gustjr3332/Polargrid/sw/edge_ai/polagrid/diagrams/polagrid_architecture.html

Dark

Style

Visual identityS cycles

ClassicStable technical default Signal FlowMotion-forward presentation BlueprintEngineering review EditorialPublication and launch notes

Live Present

Export

Export diagramPortable, clean outputs

E

Share Share Card1200×630 PNG Route Share Card1200×630 PNG Reach Share Card1200×630 PNG Copy Share CardPNG to clipboard Copy diagramPNG to clipboard

Image PNGLossless image JPEGCompact image WebPModern image

Vector & motion SVGEditable vector WebM6s motion

# PolaGrid oneM2M Hierarchy

←

Guided views

Explore this system Step through curated paths without changing the source diagram.

Beat

→

▶ Play story # Copy moment Show all

Ready Chapter 01 / 01

Guided chapter

Diagram guide Explore this system ×

Inspecting compiled semantics

01 Find any nodeSearch labels, responsibilities, kinds, and stable IDs. / 02 Trace a routeAsk how two semantic nodes connect in authored direction. R 03 See the whole systemOpen Semantic Radar with a live viewport and stable nodes. M 04 Compare semantic kindsCount roles, reveal their traffic, and compare direct authored links. L 05 Play the guided storyWalk the authored chapters and real relationships. P 06 Enter Presentation StageGive the live diagram the viewport without changing export. F

E ExportT ThemeS Style0 Reset+ Zoom in- Zoom outEsc Close

Find a node ×

⌕ /

No matching nodes

Semantic passport

Verified source

Authored reach

Upstream0 Downstream0

× Copy link Relations

Route probe Choose a start node Find start Copy link Clear

Pick two semantic nodes on the diagram

← ▶ Journey → Overview

Choose the source, then the destination. Direction matters.

Semantic lens Compare system roles ×

Choose up to two semantic kinds. One reveals its real traffic; two compare only direct authored relationships.

Choose a kind to inspect its nodes and touching relationships.

Copy link Clear

Semantic radar Building overview Open radar ×

Click nodeDrag to pan

Semantic radar needs more MAP space.

PATH MAP LENS 100%

### Measured 2026-10-07

- • 1,000 cells, edge direct: p95 344 ms
- • 1,000 cells via IN: p95 634 ms
- • 0 of 10,000 notifications lost

### Platform

- • tinyIoT c140495 + 4 local patches
- • MN throughput 458 req/s (AE per cell)
- • IN and MNs on SQLite

### Access control

- • IN rewrites CAdmin to /tinyiot/CAdmin
- • Zone ACP grants it on command CNT and GRP

### Real cell (10-19)

- • Firmware builds; PC tests pass
- • Not yet run on hardware
- • MQTT is planned, HTTP polling first
