gustjr3332/Polargrid/hw/archaive/KakaoTalk_20261017_110723910_02.jpg

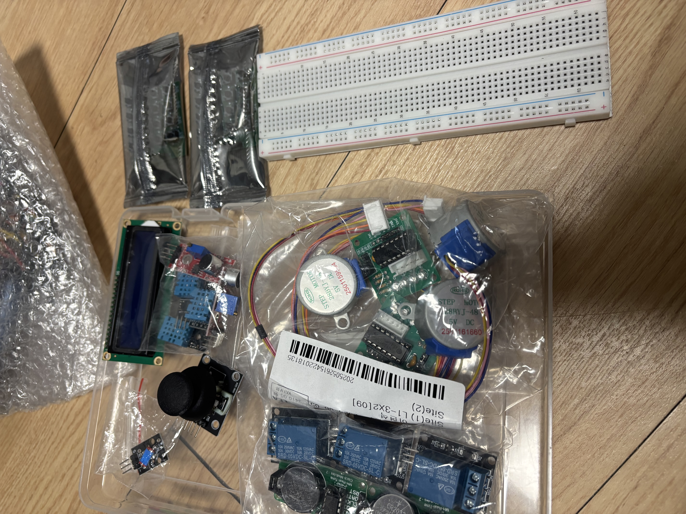
hw/archaive/KakaoTalk_20261017_110723910_02.jpg
