gustjr3332/Polargrid/hw/cutting/cut_overview.png

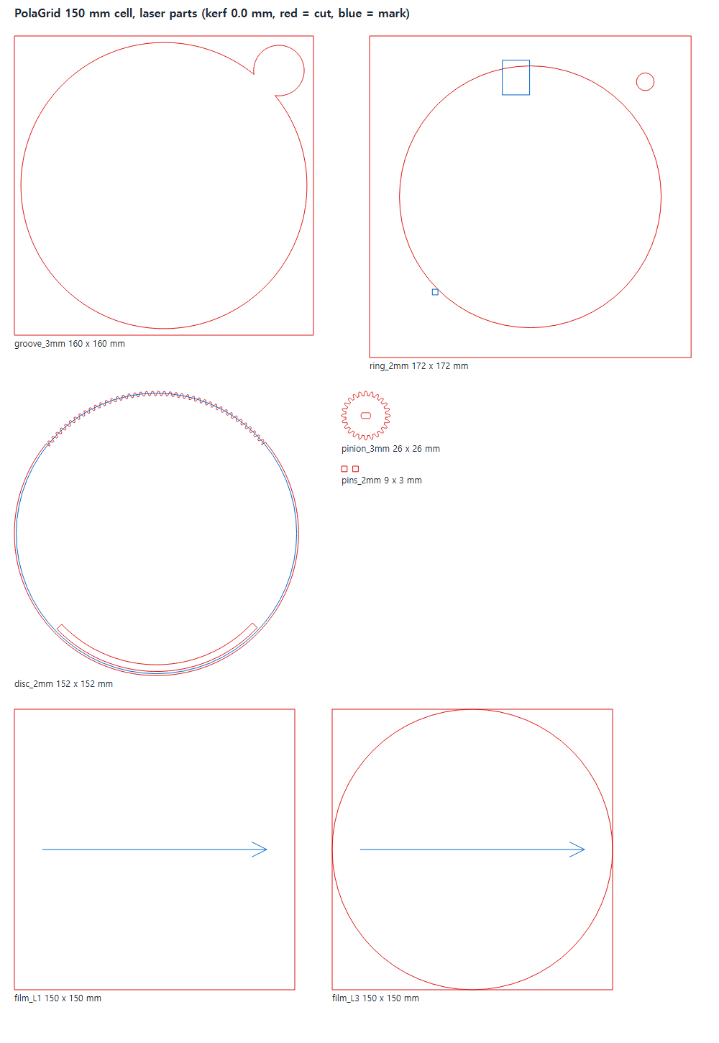
hw/cutting/cut_overview.png
