gustjr3332/Polargrid/hw/diagrams/images/cell150_dark.png

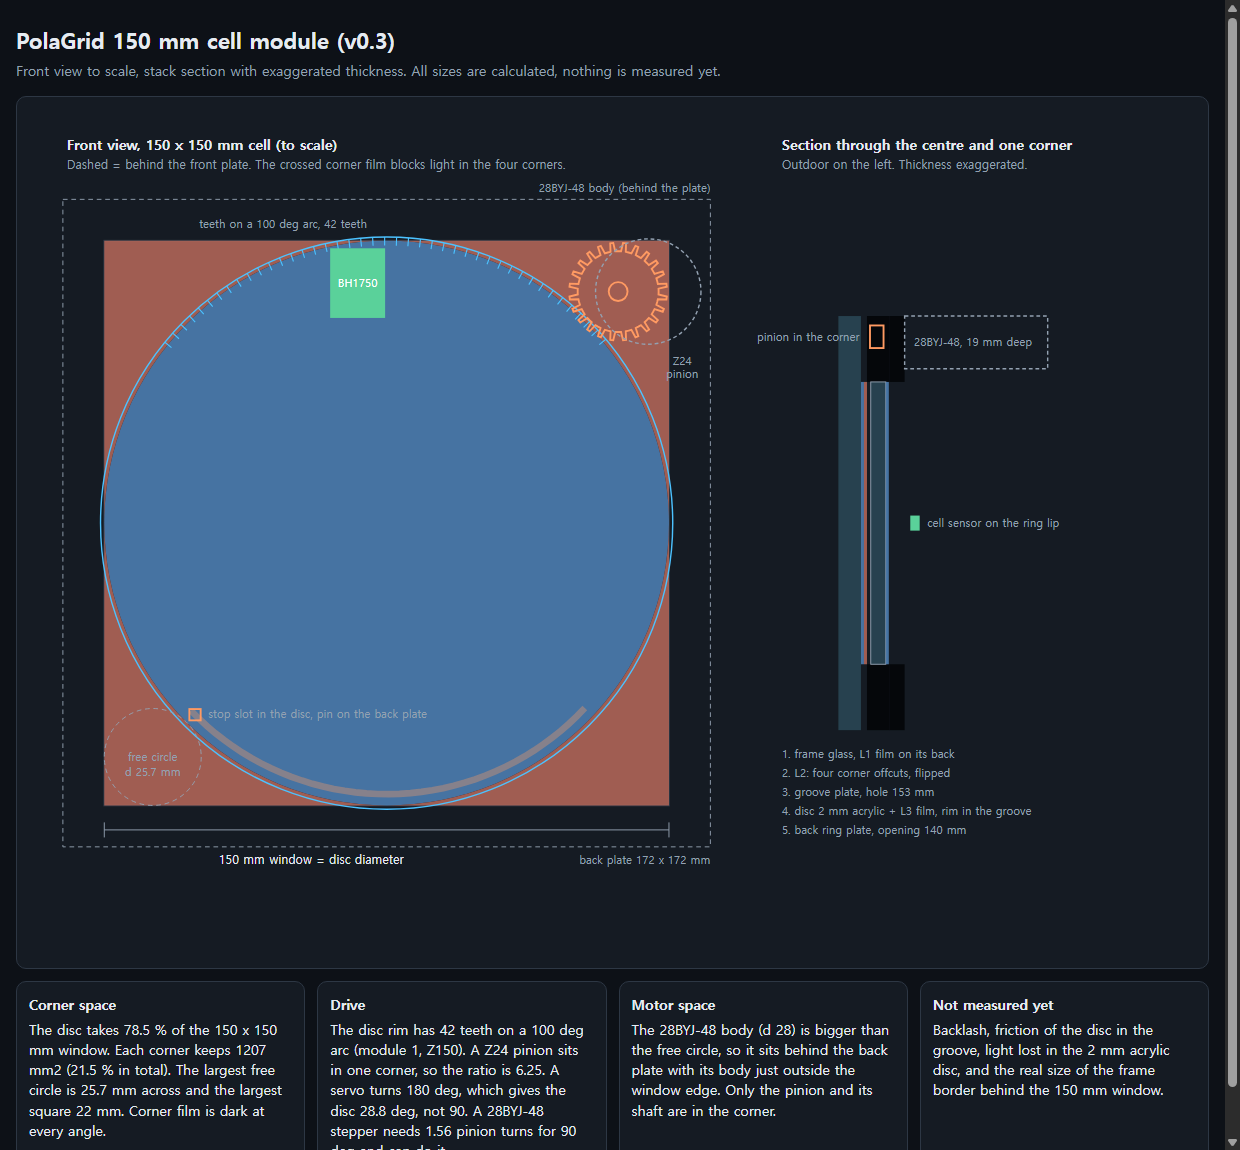
hw/diagrams/images/cell150_dark.png
