gustjr3332/Polargrid/hw/diagrams/images/cell150_ko_dark.png

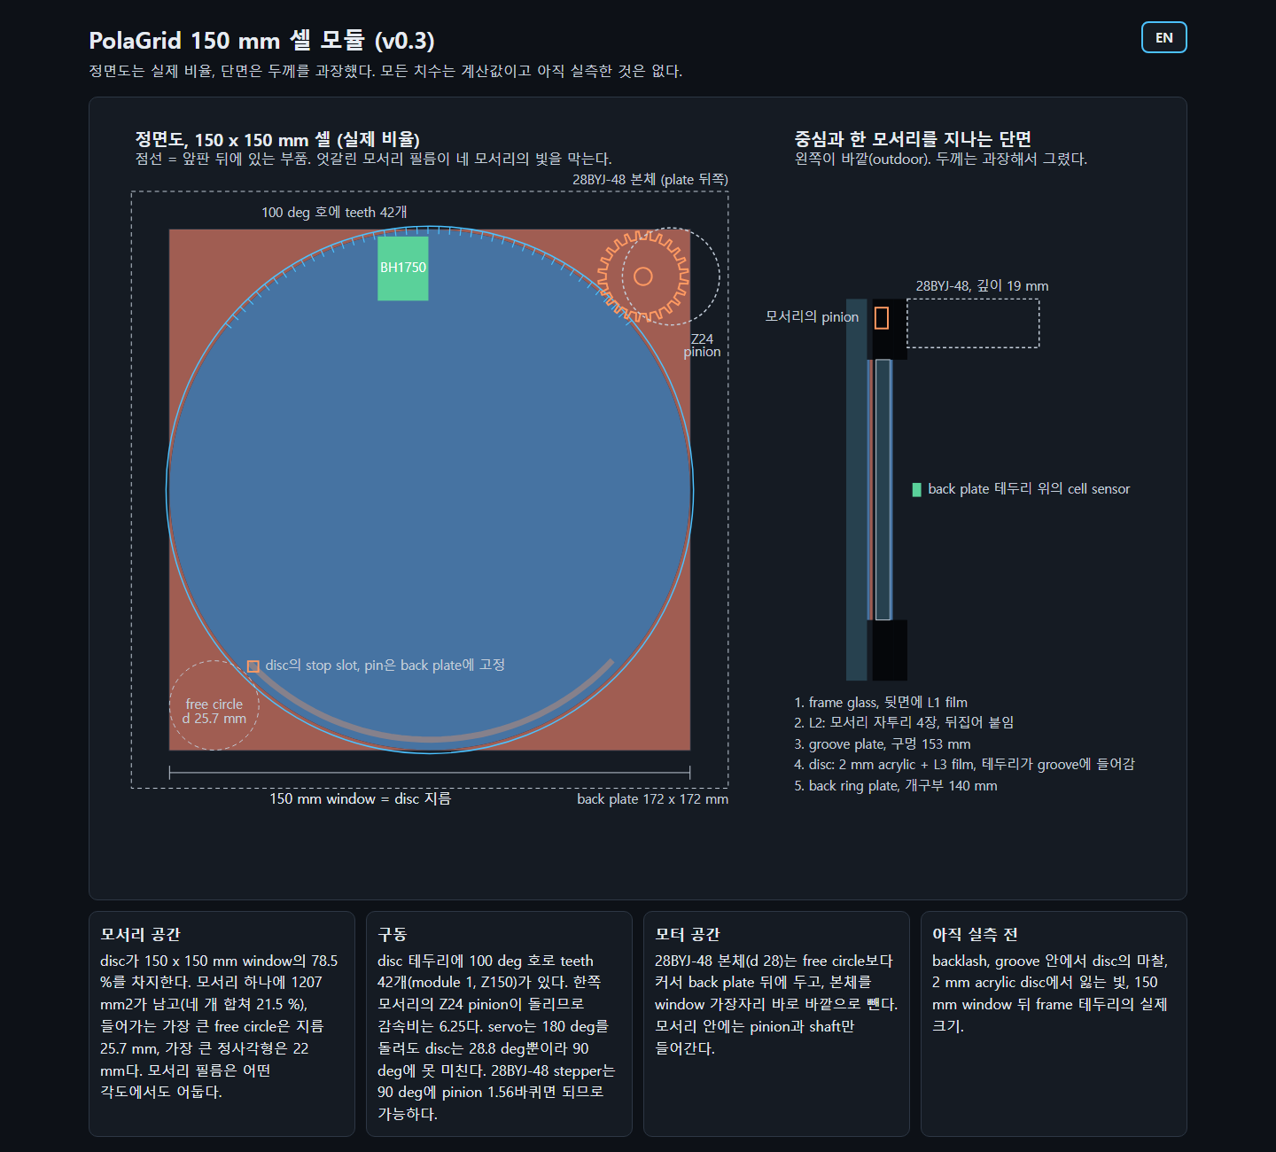
hw/diagrams/images/cell150_ko_dark.png
