gustjr3332/Polargrid/hw/diagrams/images/cell150_ko_light.png

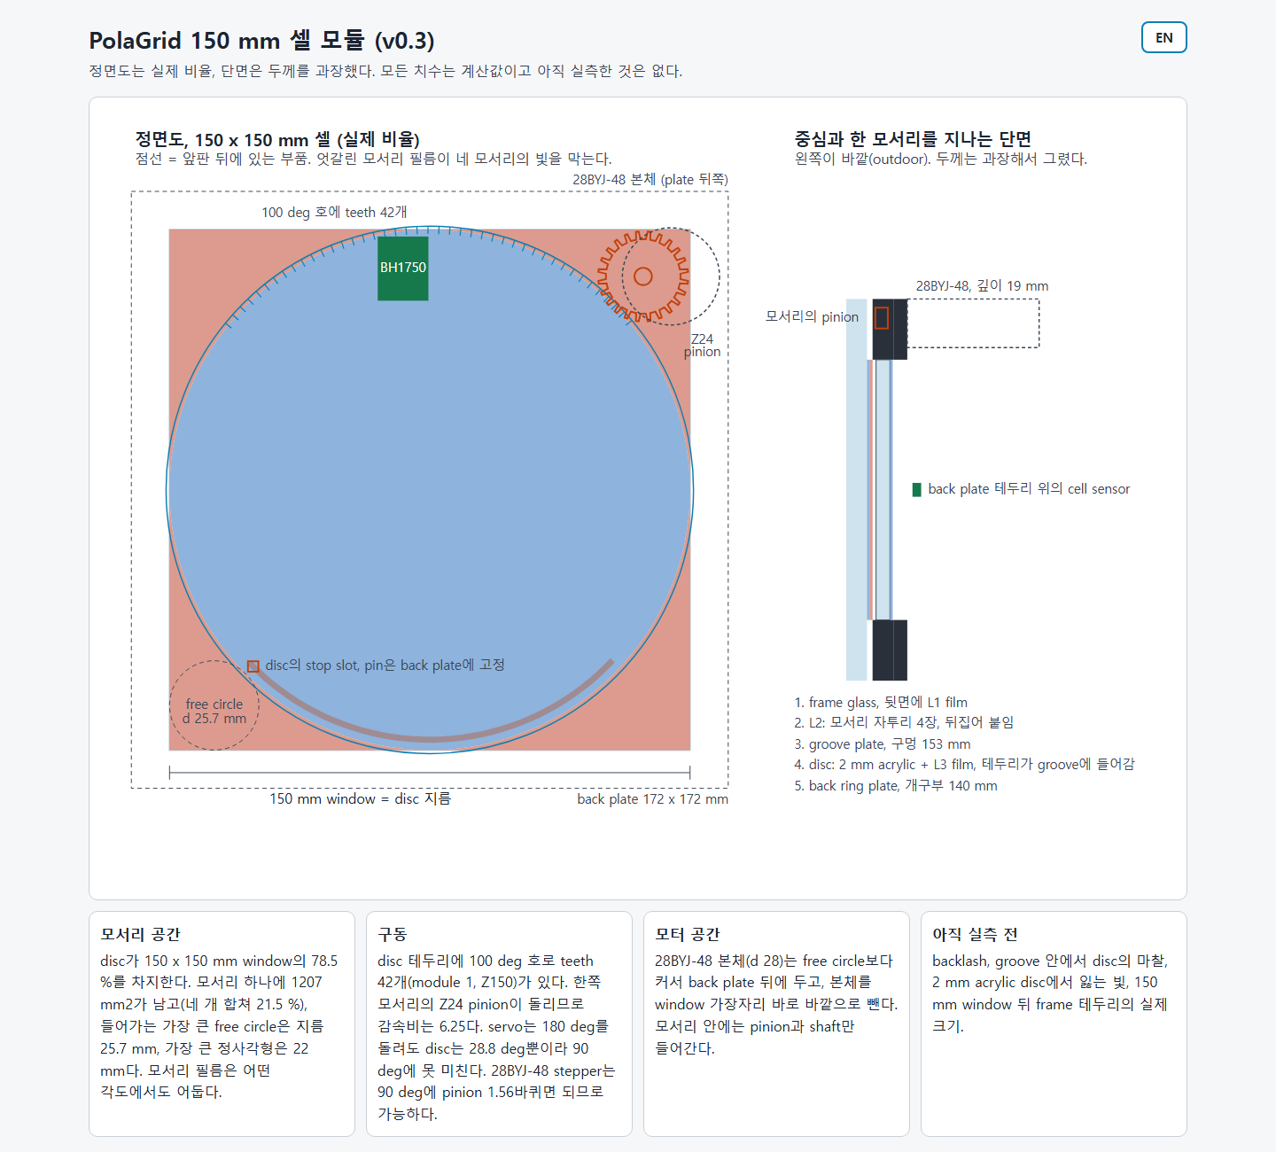
hw/diagrams/images/cell150_ko_light.png
