gustjr3332/Polargrid/hw/diagrams/images/cell150_light.png

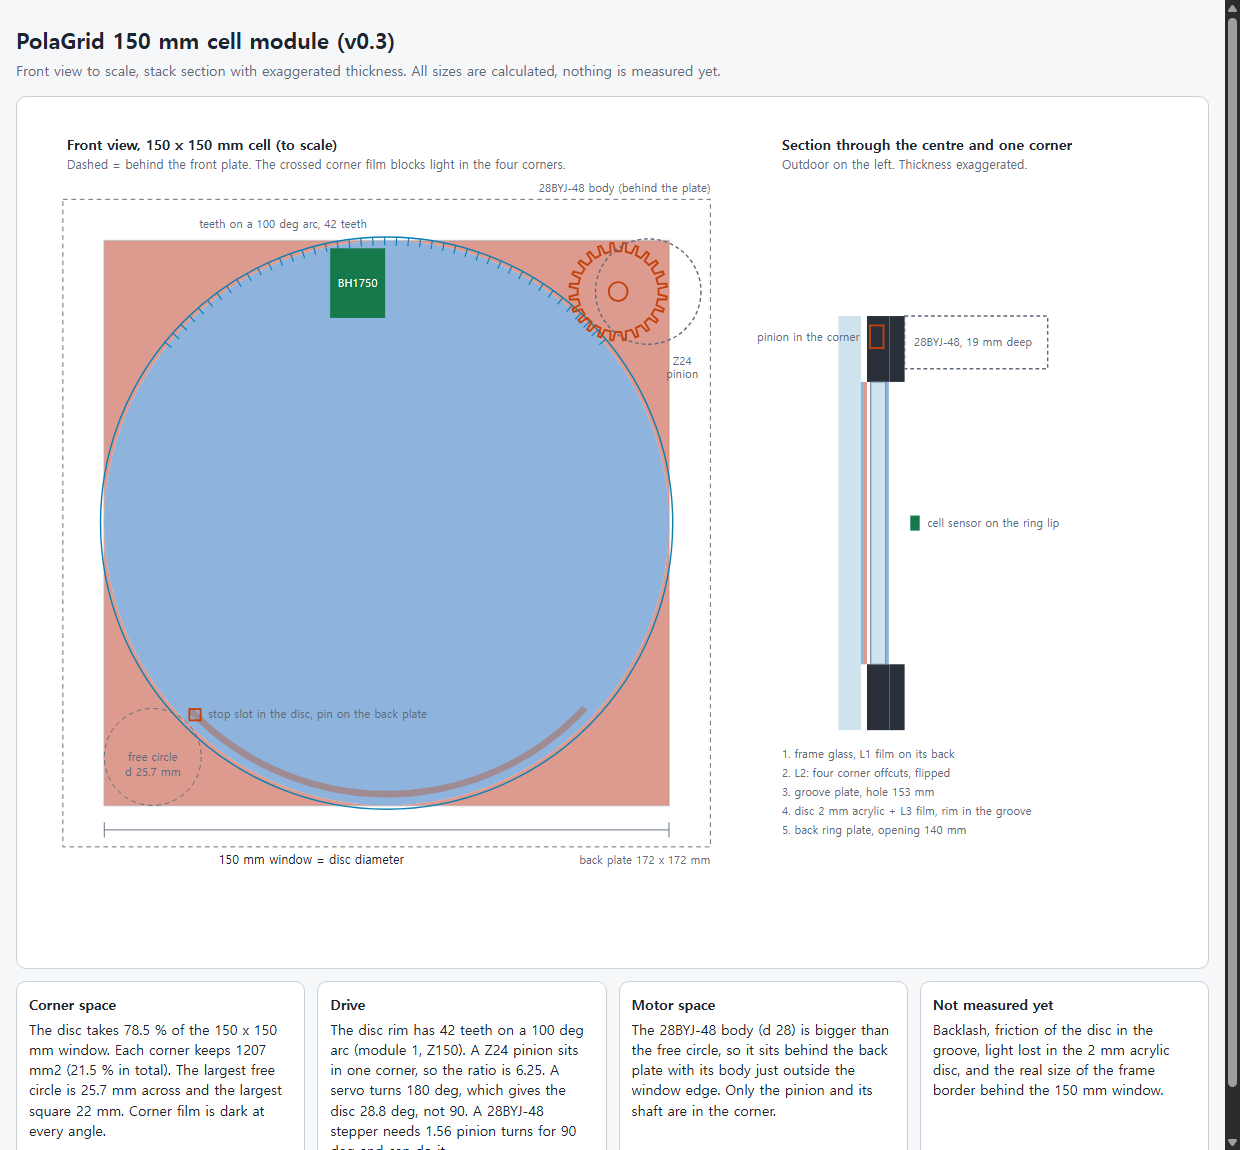
hw/diagrams/images/cell150_light.png
