gustjr3332/Polargrid/hw/diagrams/images/concept_dark.png

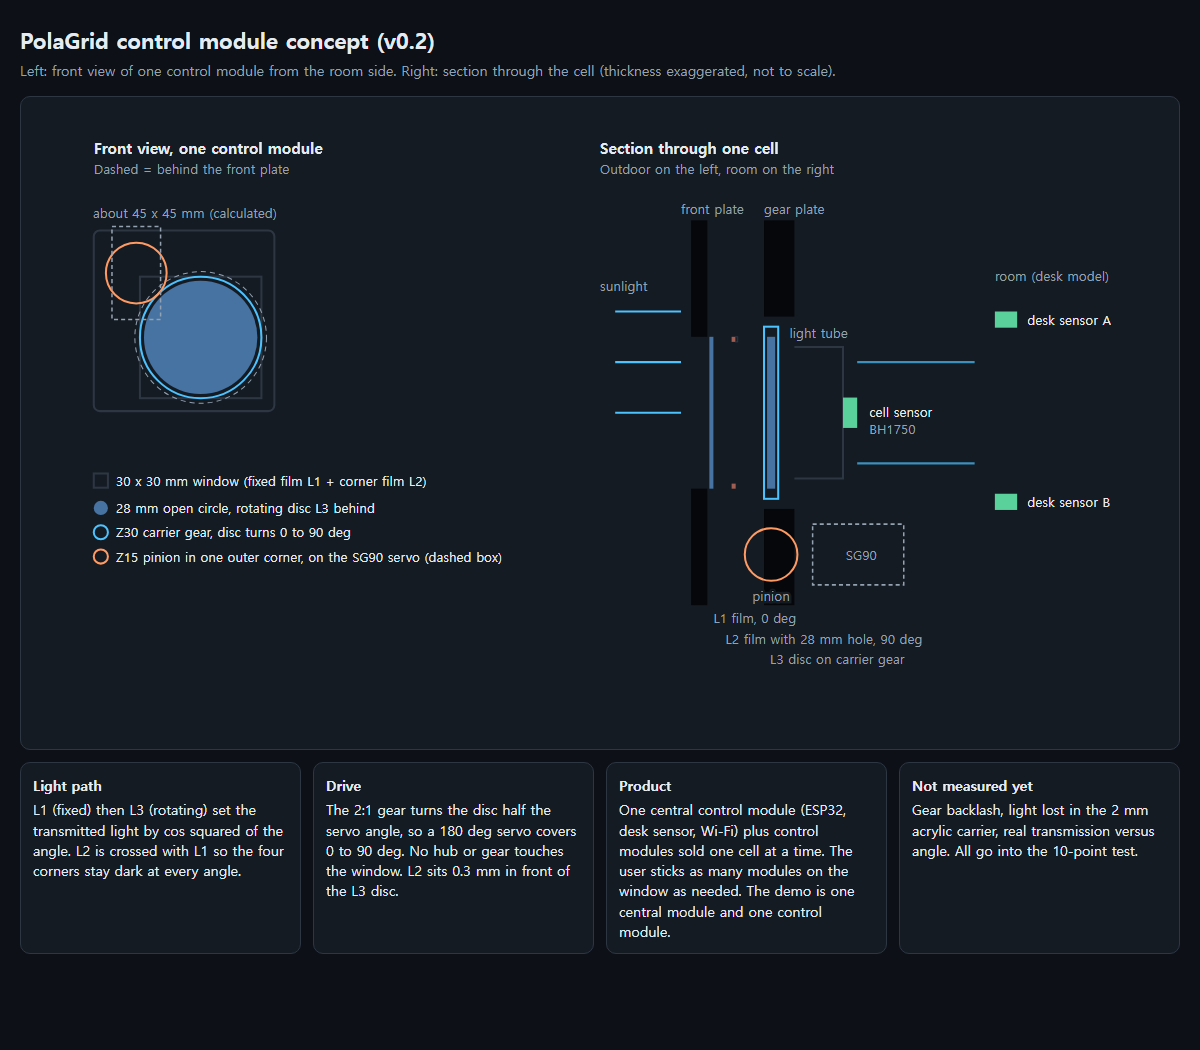
hw/diagrams/images/concept_dark.png
