gustjr3332/Polargrid/hw/diagrams/images/concept_light.png

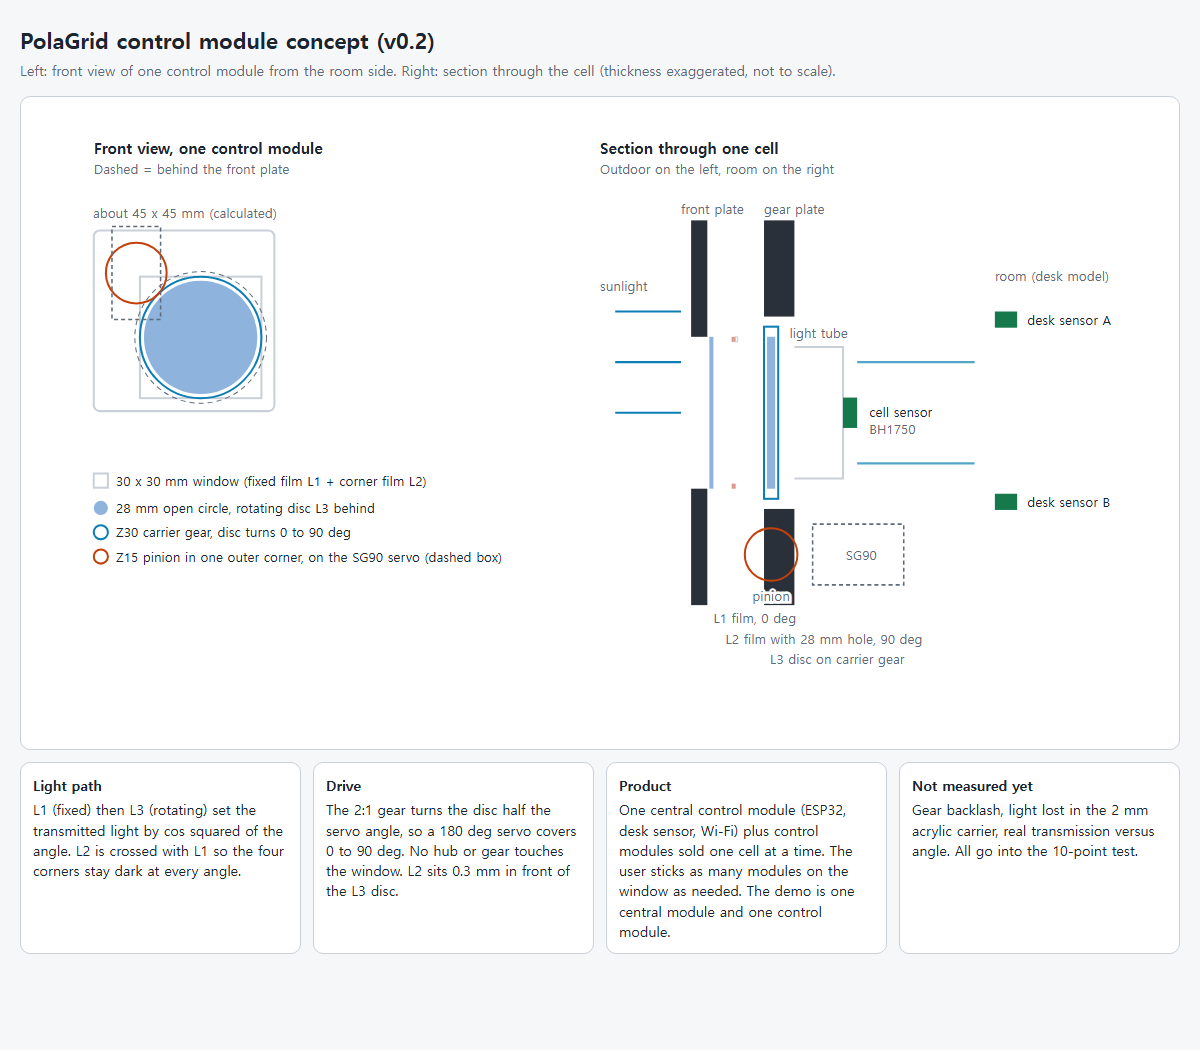
hw/diagrams/images/concept_light.png
