gustjr3332/Polargrid/hw/diagrams/sensor_dataflow_a.png

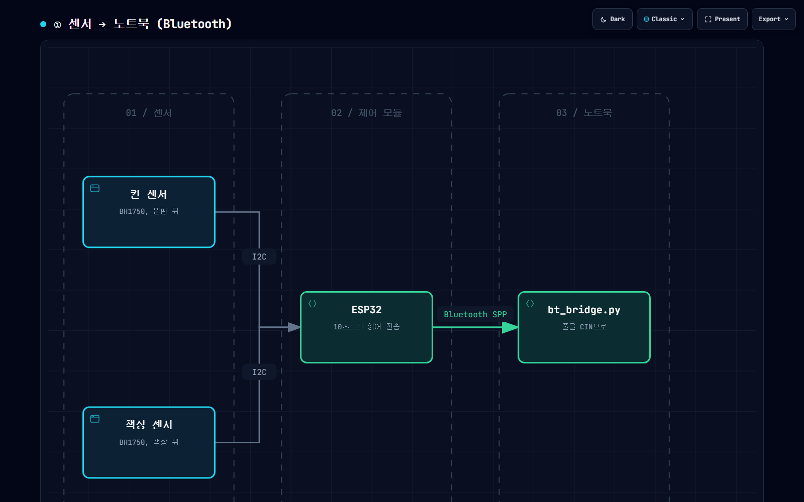
hw/diagrams/sensor_dataflow_a.png
