gustjr3332/Polargrid/hw/diagrams/sensor_dataflow_b.png

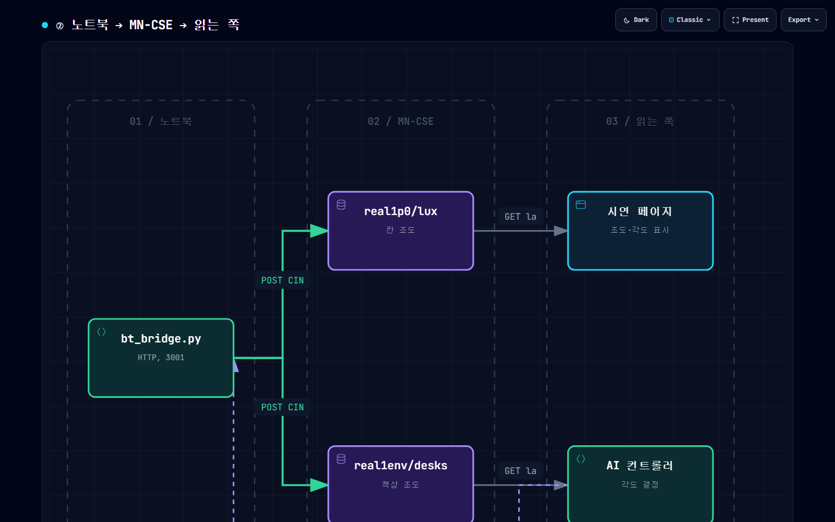
hw/diagrams/sensor_dataflow_b.png
