gustjr3332/Polargrid/sw/app_ui/mockup/screens/comfort.png

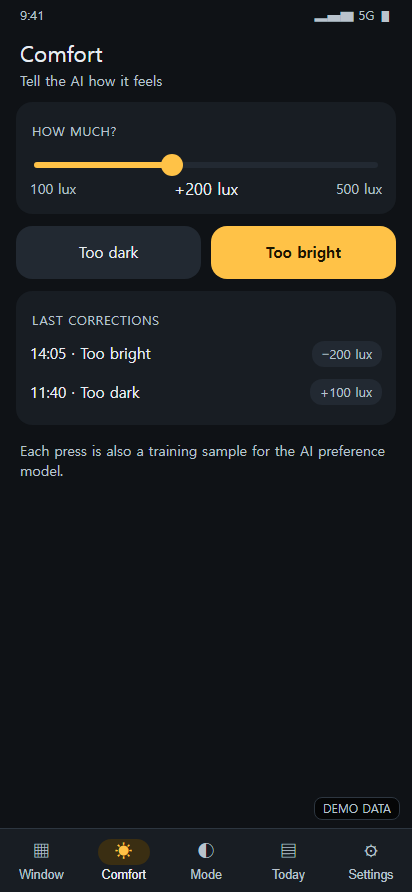
sw/app_ui/mockup/screens/comfort.png
