gustjr3332/Polargrid/sw/app_ui/mockup/screens/comfort_ko.png

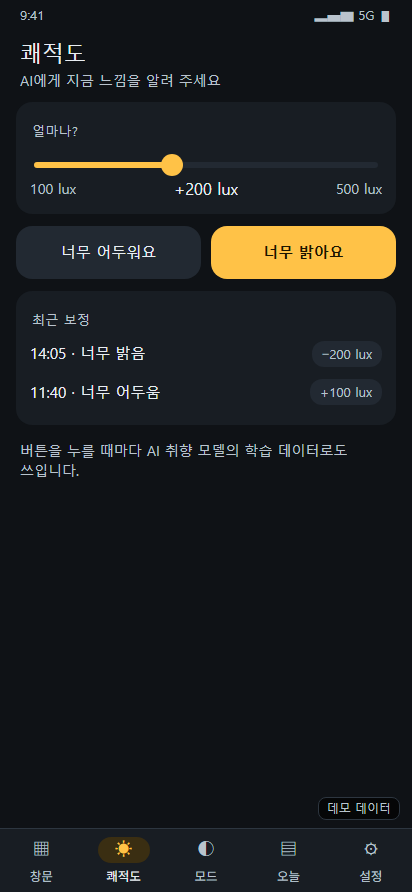
sw/app_ui/mockup/screens/comfort_ko.png
