gustjr3332/Polargrid/sw/app_ui/mockup/screens/mode_en.png

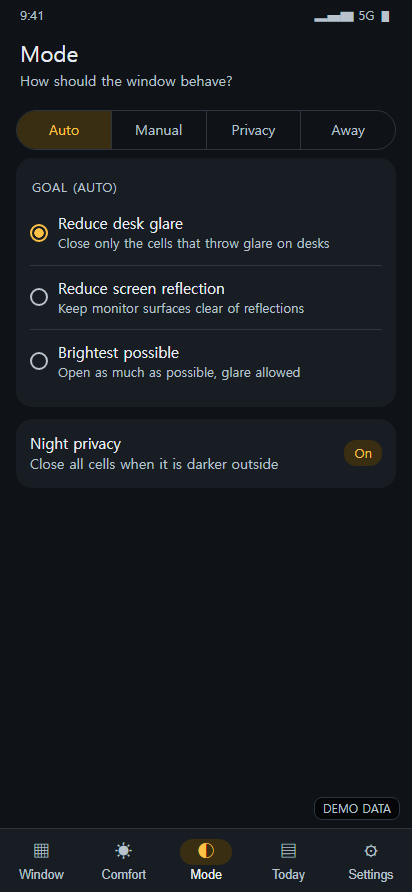
sw/app_ui/mockup/screens/mode_en.png
