gustjr3332/Polargrid/sw/app_ui/mockup/screens/mode_ko.png

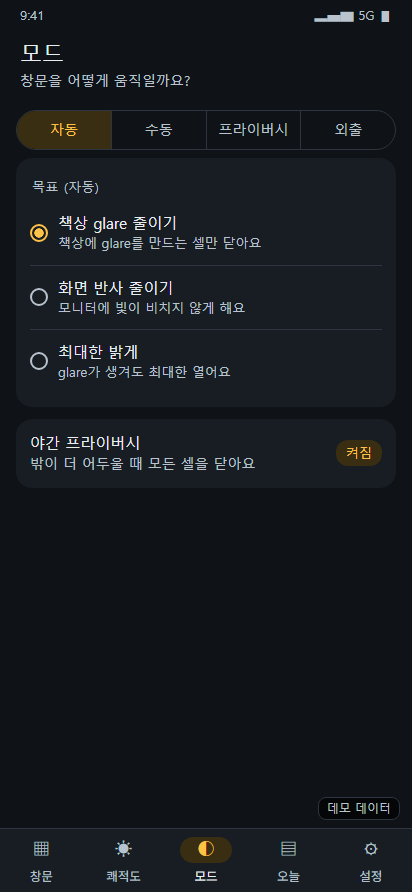
sw/app_ui/mockup/screens/mode_ko.png
