gustjr3332/Polargrid/sw/app_ui/mockup/screens/overview.png

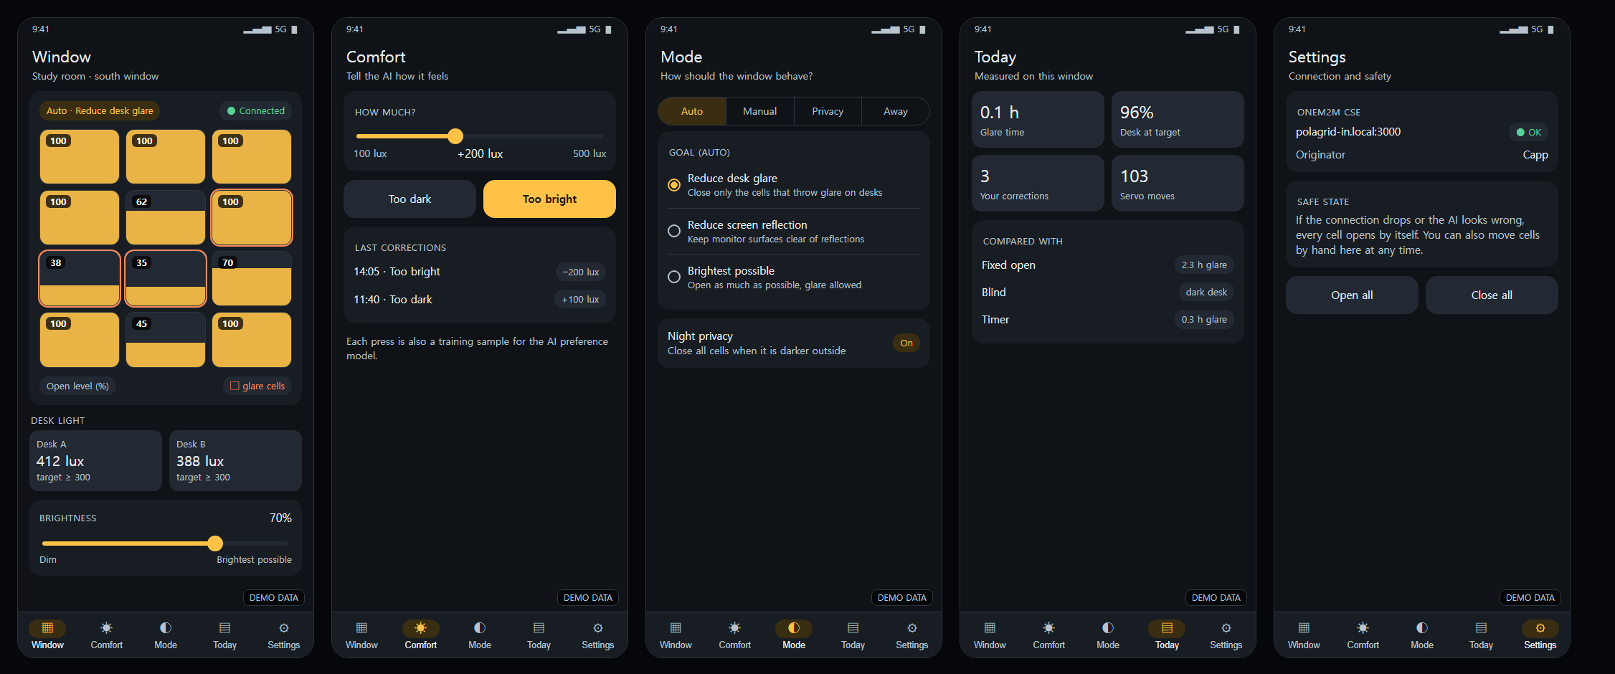
sw/app_ui/mockup/screens/overview.png
