gustjr3332/Polargrid/sw/app_ui/mockup/screens/settings.png

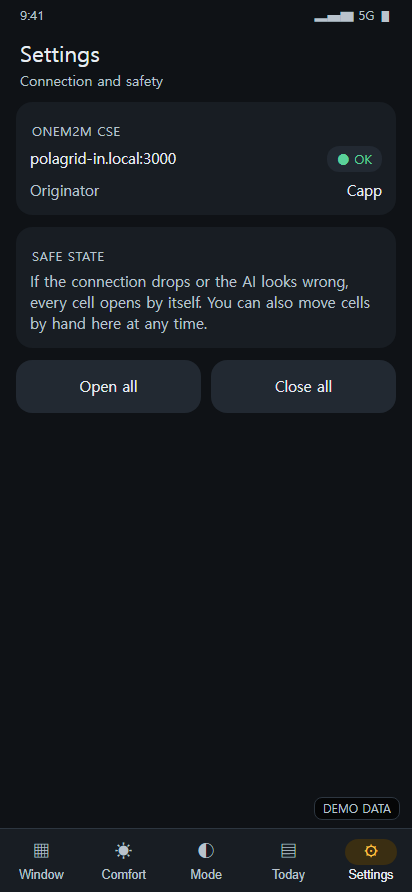
sw/app_ui/mockup/screens/settings.png
