gustjr3332/Polargrid/sw/app_ui/mockup/screens/settings_ko.png

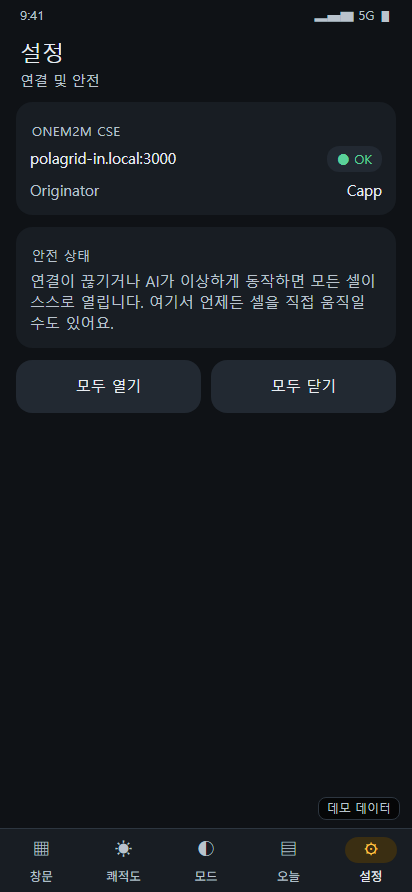
sw/app_ui/mockup/screens/settings_ko.png
