gustjr3332/Polargrid/sw/app_ui/mockup/screens/today_en.png

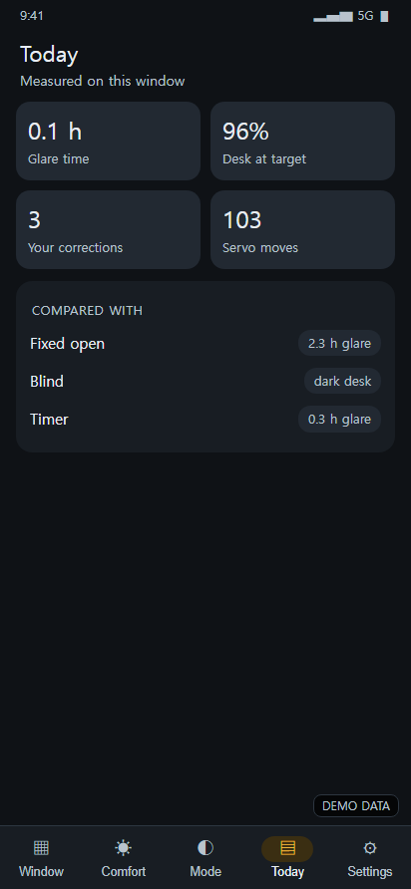
sw/app_ui/mockup/screens/today_en.png
