gustjr3332/Polargrid/sw/app_ui/mockup/screens/window_en.png

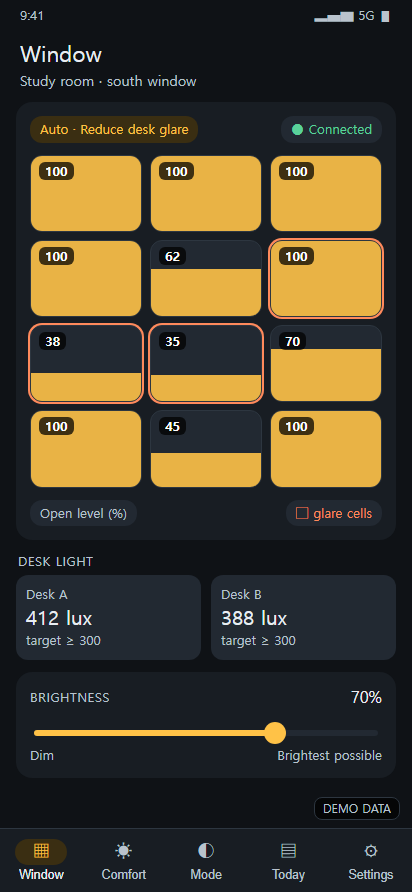
sw/app_ui/mockup/screens/window_en.png
