gustjr3332/Polargrid/sw/edge_ai/polagrid/diagrams/polagrid_architecture.png

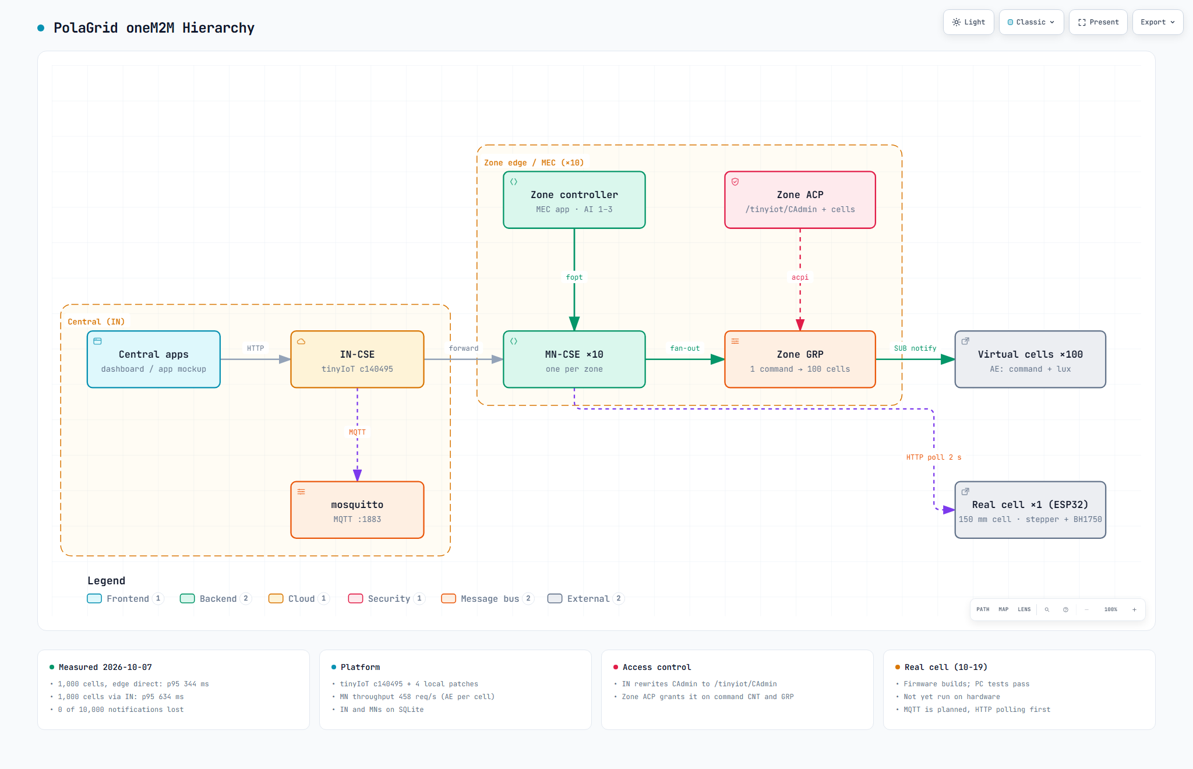
sw/edge_ai/polagrid/diagrams/polagrid_architecture.png
