gustjr3332/Polargrid/sw/edge_ai/polagrid/diagrams/polagrid_architecture_dark.png

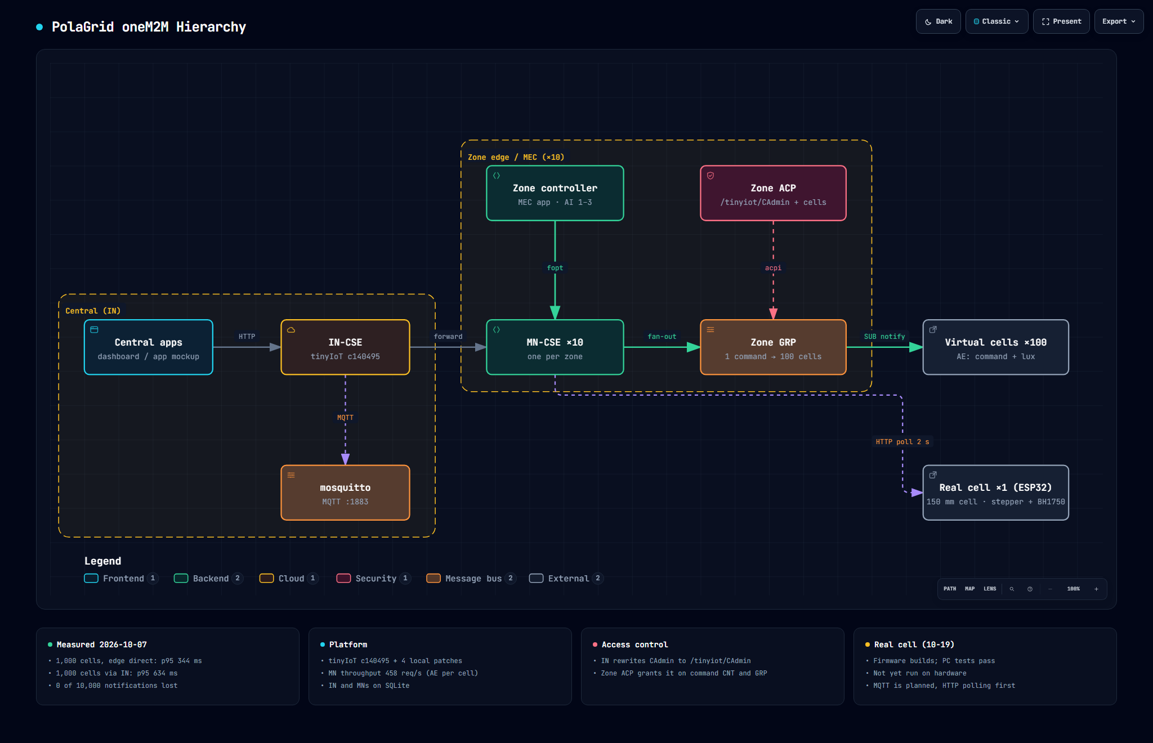
sw/edge_ai/polagrid/diagrams/polagrid_architecture_dark.png
