gustjr3332/Polargrid/hw/cutting/disc_3mm.dxf

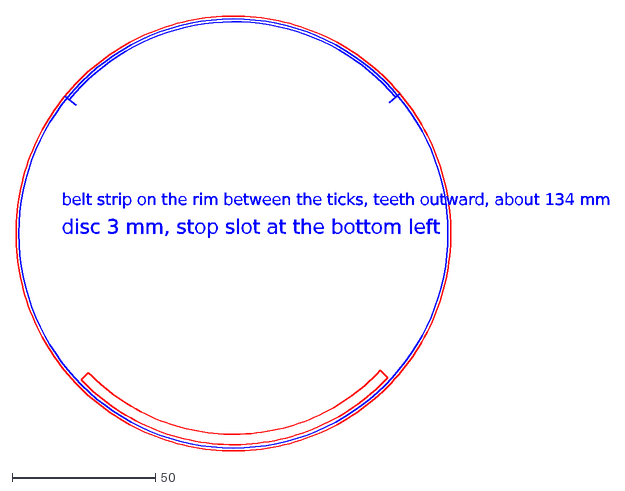
[picture p25: CAD file, 2026-10-25]
hw/cutting/disc_3mm.dxf
disc 3 mm, stop slot at the bottom left
belt strip on the rim between the ticks, teeth outward, about 134 mm
