gustjr3332/Polargrid/hw/cutting/disc_2mm.dxf

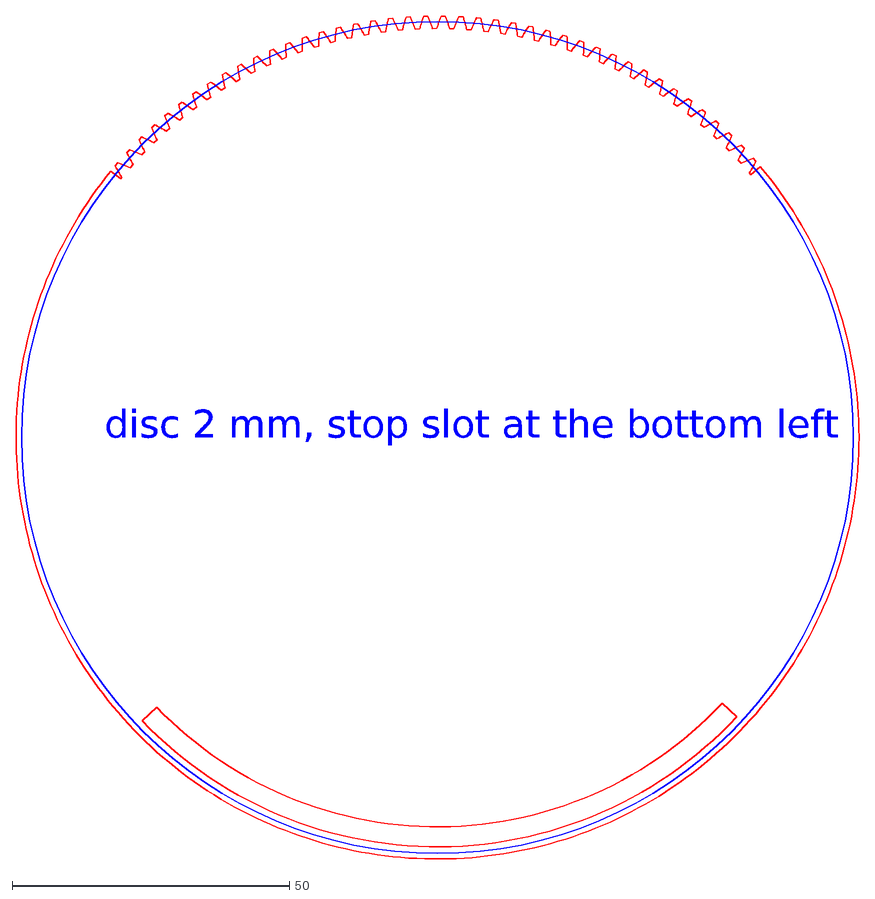
[picture p26: CAD file, 2026-10-18]
hw/cutting/disc_2mm.dxf
disc 2 mm, stop slot at the bottom left
