gustjr3332/Polargrid/hw/cutting/pins_2mm.dxf

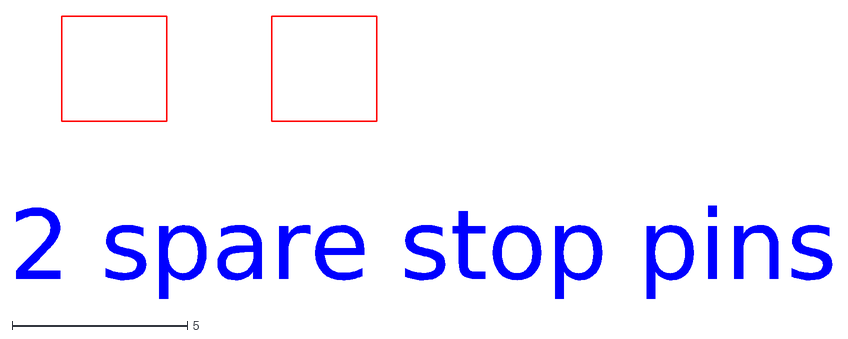
[picture p27: CAD file, 2026-10-18]
hw/cutting/pins_2mm.dxf
2 spare stop pins
