gustjr3332/Polargrid/hw/cutting/ring_2mm.dxf

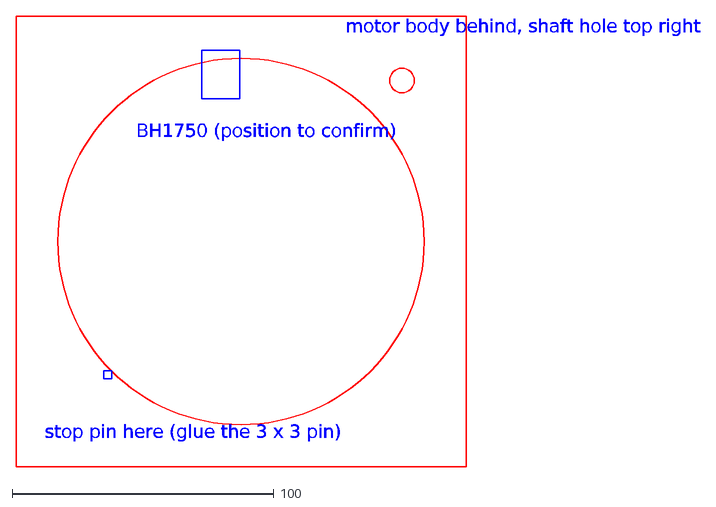
[picture p28: CAD file, 2026-10-18]
hw/cutting/ring_2mm.dxf
BH1750 (position to confirm)
stop pin here (glue the 3 x 3 pin)
motor body behind, shaft hole top right
