gustjr3332/Polargrid/hw/cutting/groove_3mm.dxf

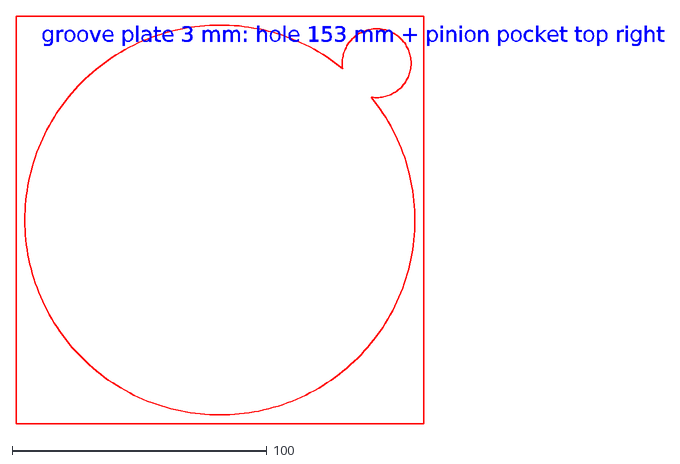
[picture p29: CAD file, 2026-10-18]
hw/cutting/groove_3mm.dxf
groove plate 3 mm: hole 153 mm + pinion pocket top right
