gustjr3332/Polargrid/hw/cutting/pinion_3mm.dxf

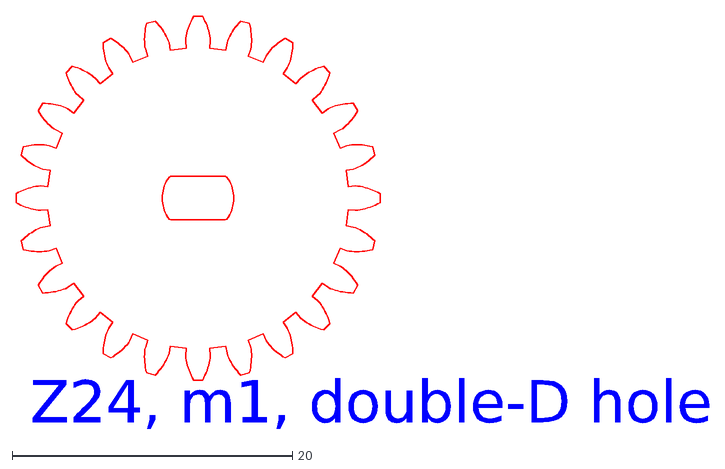
[picture p30: CAD file, 2026-10-18]
hw/cutting/pinion_3mm.dxf
Z24, m1, double-D hole
