gustjr3332/Polargrid/hw/cutting/film_L1.dxf

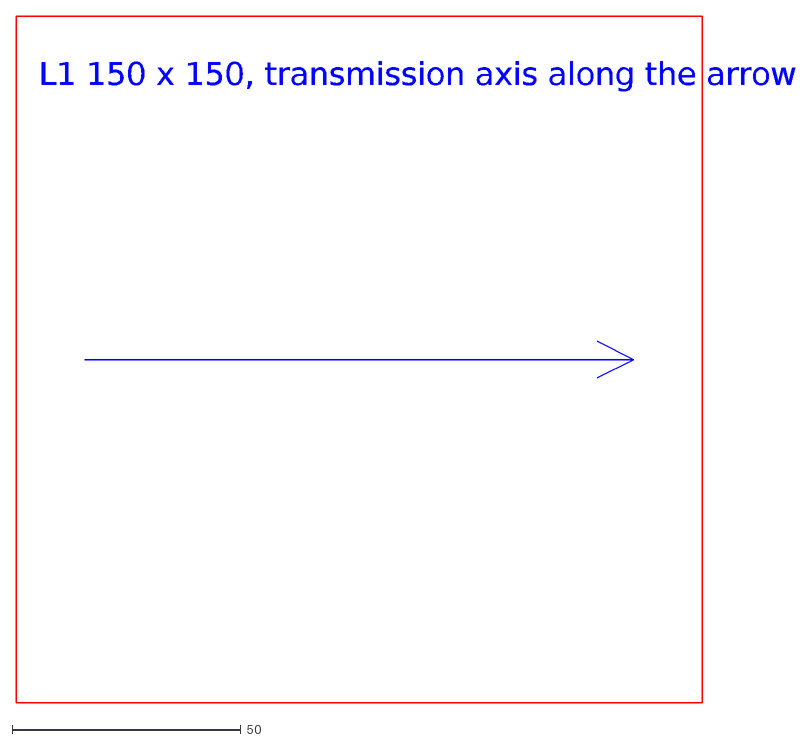
[picture p31: CAD file, 2026-10-18]
hw/cutting/film_L1.dxf
L1 150 x 150, transmission axis along the arrow
