gustjr3332/Polargrid/hw/cutting/film_L3.dxf

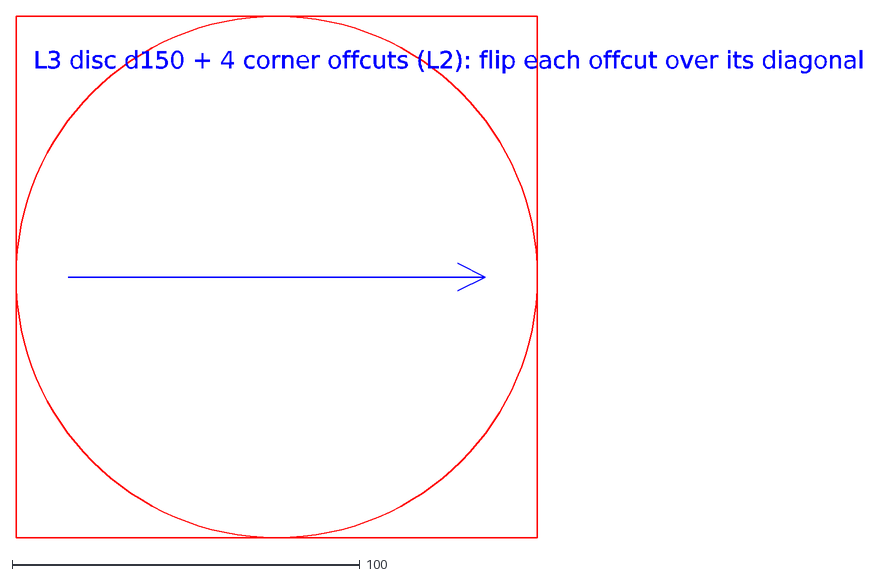
[picture p32: CAD file, 2026-10-18]
hw/cutting/film_L3.dxf
L3 disc d150 + 4 corner offcuts (L2): flip each offcut over its diagonal
