gustjr3332/Polargrid/hw/diagrams/images/wiring_dark.png

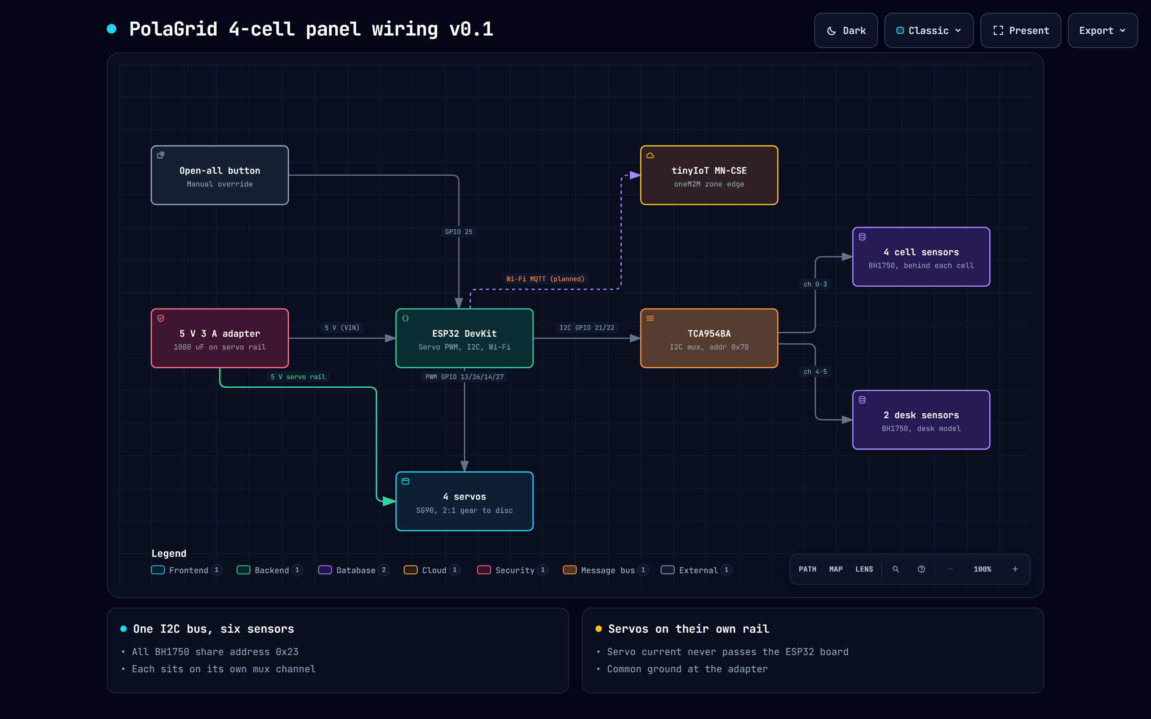
hw/diagrams/images/wiring_dark.png
