gustjr3332/Polargrid/hw/diagrams/wiring.ko.visual-check.1440x900.light.png

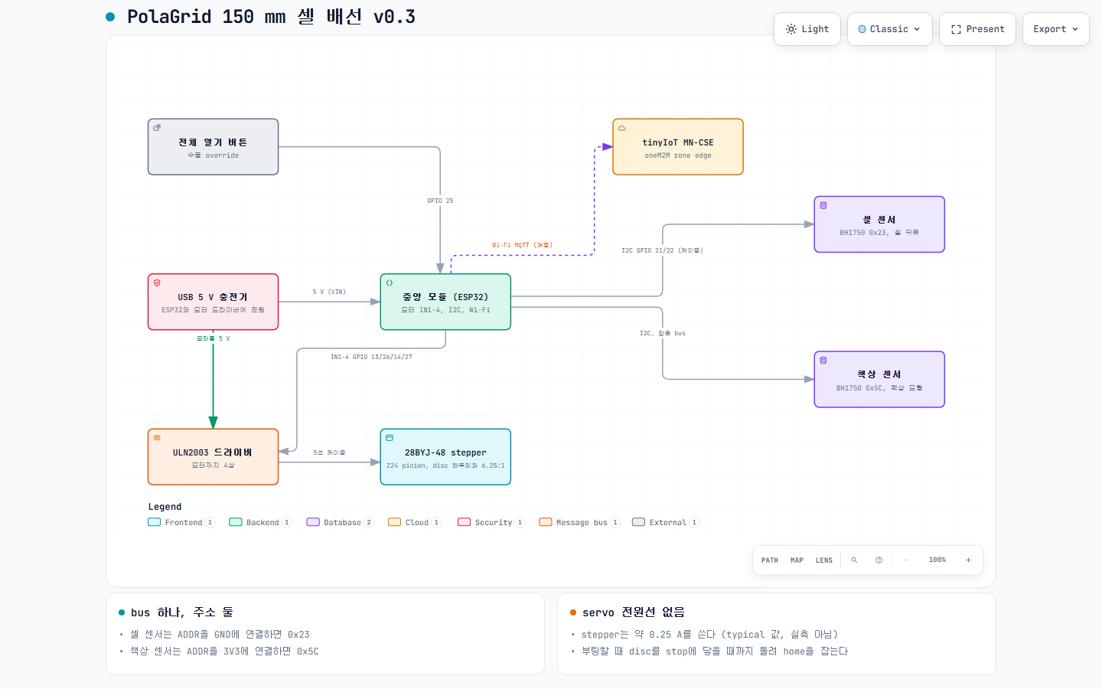
hw/diagrams/wiring.ko.visual-check.1440x900.light.png
