gustjr3332/Polargrid/hw/diagrams/wiring.ko.visual-check.2048x1320.dark.png

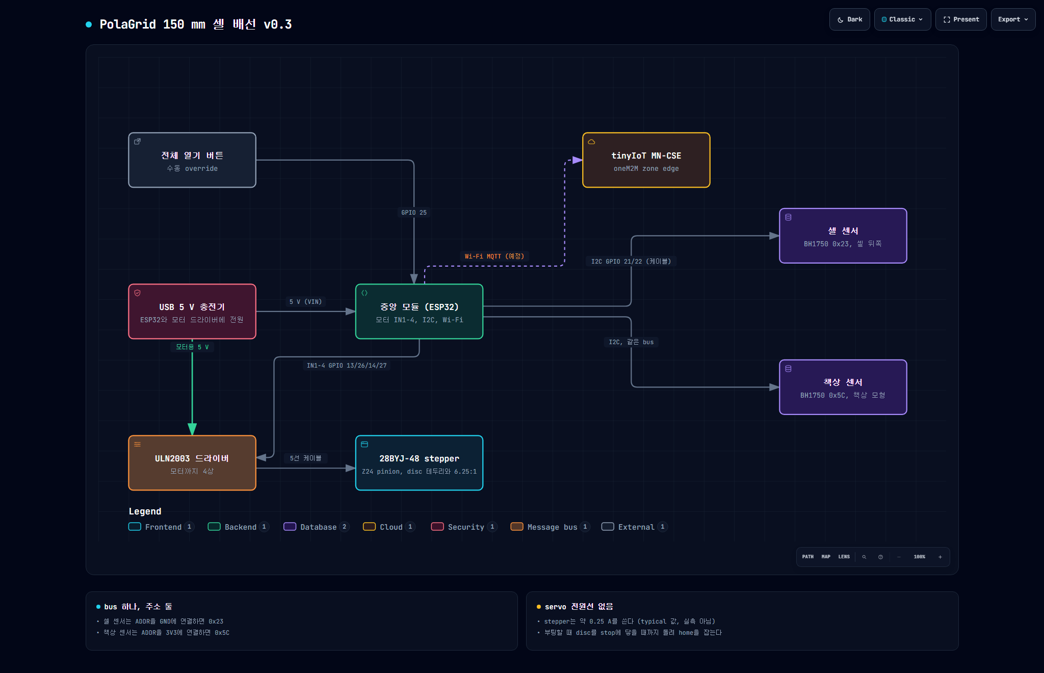
hw/diagrams/wiring.ko.visual-check.2048x1320.dark.png
