gustjr3332/Polargrid/sw/edge_ai/results/real_cell_sweep_1101_1505.csv

# run real1 | sensor cell | 3 readings per angle | 2026-11-01T15:05:34.698044+09:00
angle | lux | ratio
0 | 37.8 | 1.0
10 | 16.4 | 0.4342
20 | 27.5 | 0.7282
30 | 20.8 | 0.5516
40 | 13.3 | 0.3522
50 | 12.2 | 0.3239
60 | 8.3 | 0.2198
70 | 0.8 | 0.0221
80 | 0.8 | 0.0221
90 | 14.2 | 0.3751
0 | 53.6 | 1.4192
