gustjr3332/Polargrid/sw/edge_ai/results/real_cell_sweep_1101_1516.csv

# run real1 | sensor cell | 5 readings per angle | 2026-11-01T15:16:05.080373+09:00
angle | lux | ratio
0 | 85.8 | 1.0
10 | 65.8 | 0.7669
20 | 69.0 | 0.8042
30 | 29.2 | 0.3403
40 | 19.7 | 0.2294
50 | 8.3 | 0.0967
60 | 2.5 | 0.0291
70 | 0.0 | 0.0
80 | 2.5 | 0.0291
90 | 8.3 | 0.0967
0 | 90.3 | 1.0527
