gustjr3332/Polargrid/sw/edge_ai/results/in_outage_1027.csv

t | kind | angle | status | ms | extra
1793082205.643 | mn |  | 200 | 2 | 100
1793082205.644 | viaIN |  | 200 | 1
1793082210.647 | mn |  | 200 | 2 | 100
1793082210.653 | viaIN |  | 200 | 2
1793082212.841 | cmd | 45 | ok | 7200
1793082215.666 | mn |  | 200 | 1 | 50
1793082215.667 | viaIN |  | 200 | 1
1793082220.670 | mn |  | 200 | 2 | 50
1793082220.672 | viaIN |  | 200 | 2
1793082225.673 | mn |  | 200 | 4 | 50
1793082225.677 | viaIN |  | 200 | 3
1793082230.679 | mn |  | 200 | 4 | 50
1793082230.682 | viaIN |  | 200 | 3
1793082233.054 | cmd | 90 | ok | 7407
1793082233.057 | cmdIN | 90.0 | 200 | 3 | fk1v1
1793082238.061 | mn |  | 200 | 4 | 0
1793082238.064 | viaIN |  | 200 | 2
1793082243.069 | mn |  | 200 | 4 | 0
1793082243.072 | viaIN |  | 200 | 2
1793082248.080 | mn |  | 200 | 2 | 0
1793082248.084 | viaIN |  | 200 | 4
1793082253.088 | mn |  | 200 | 3 | 50
1793082253.091 | viaIN |  | 200 | 2
1793082253.272 | cmd | 45 | ok | 7625
1793082258.093 | mn |  | 200 | 2 | 50
1793082258.096 | viaIN |  | 200 | 2
1793082265.309 | mn |  | 200 | 4 | 50
1793082265.312 | viaIN |  | 200 | 2
1793082265.316 | cmdIN | 45.0 | 200 | 3 | fk1v2
1793082270.318 | mn |  | 200 | 2 | 50
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
