gustjr3332/Polargrid/sw/edge_ai/results/in_outage_1027_run1.csv

t | kind | angle | status | ms | extra
1793080994.002 | mn |  | 200 | 1 | 100
1793080994.004 | viaIN |  | 200 | 1
1793080999.008 | mn |  | 200 | 3 | 100
1793080999.010 | viaIN |  | 200 | 2
1793081003.140 | cmd | 45 | ok | 7273
1793081005.878 | mn |  | 200 | 1 | 50
1793081005.885 | viaIN |  | 200 | 5
1793081010.889 | mn |  | 200 | 4 | 50
1793081010.894 | viaIN |  | 200 | 4
1793081015.897 | mn |  | 200 | 3 | 50
1793081015.900 | viaIN |  | 200 | 2
1793081020.902 | mn |  | 200 | 1 | 50
1793081020.908 | viaIN |  | 200 | 5
1793081020.911 | cmdIN | 45.0 | 200 | 2 | fk1v1
1793081025.916 | mn |  | 200 | 4 | 50
1793081025.921 | viaIN |  | 200 | 5
1793081030.926 | mn |  | 200 | 4 | 50
1793081030.931 | viaIN |  | 200 | 5
1793081038.047 | mn |  | 200 | 4 | 50
1793081038.055 | viaIN |  | 200 | 3
1793081043.059 | mn |  | 200 | 3 | 50
1793081043.061 | viaIN |  | 200 | 2
1793081047.989 | cmd | 90 | noreply
1793081048.063 | mn |  | 200 | 1 | 50
1793081048.065 | viaIN |  | 200 | 1
1793081049.154 | cmd | 45 | ok | 1165
1793081053.069 | mn |  | 200 | 4 | 50
1793081053.071 | viaIN |  | 200 | 2
1793081053.075 | cmdIN | 45.0 | 200 | 3 | fk1v2
1793081058.076 | mn |  | 200 | 1 | 50
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
