gustjr3332/Polargrid/sw/edge_ai/results/locust_50_stats.csv

Type | Name | Request Count | Failure Count | Median Response Time | Average Response Time | Min Response Time | Max Response Time | Average Content Size | Requests/s | Failures/s | 50% | 66% | 75% | 80% | 90% | 95% | 98% | 99% | 99.9% | 99.99% | 100%
POST | CIN angle | 20 | 0 | 53 | 627.4760599946603 | 7.518699858337641 | 2360.298100160435 | 219.0 | 0.4554207586822894 | 0.0 | 53 | 870 | 1500 | 1800 | 1800 | 2400 | 2400 | 2400 | 2400 | 2400 | 2400
POST | CIN command (admin) | 18 | 0 | 29 | 243.3061556140375 | 7.41389999166131 | 2245.415500132367 | 232.77777777777777 | 0.4098786828140605 | 0.0 | 29 | 32 | 73 | 170 | 1300 | 2200 | 2200 | 2200 | 2200 | 2200 | 2200
POST | CIN lux | 292 | 0 | 74 | 382.62397945501317 | 7.196100195869803 | 2803.958799922839 | 220.17808219178082 | 6.649143076761425 | 0.0 | 74 | 280 | 440 | 660 | 1300 | 1900 | 2400 | 2600 | 2800 | 2800 | 2800
GET | GET command/la | 72 | 0 | 50 | 164.70137222333707 | 8.300499990582466 | 1361.072100000456 | 65.90277777777777 | 1.639514731256242 | 0.0 | 50 | 170 | 260 | 320 | 450 | 600 | 830 | 1400 | 1400 | 1400 | 1400
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
