gustjr3332/Polargrid/sw/edge_ai/tools/real_cell.py

"""PC side of the ONE real cell (ESP32 firmware in sw/actuator): drives it through the MN-CSE it polls.

The firmware makes the zone.py resources for one cell ({run}env/sun, {run}env/desks, {run}p0/command, state, lux),
so this script runs the normal polagrid Controller as the zone controller of a one-cell zone. --run, --host and --cse
match RUN_ID, CSE_HOST and CSE_NAME in sw/actuator/src/secrets.h (--host as this PC sees the MN). Setup is safe to
repeat with the same run id. Run inside WSL next to the MN, because the CSE calls back into this process on --port.

    python3 tools/real_cell.py --run real1 manual          # type angles 0..90, see state, lux and latency
    python3 tools/real_cell.py --run real1 manual 45 90 0  # the same with angles from the command line
    python3 tools/real_cell.py --run real1 sweep --n 5     # angle vs lux, 0,10,..,90,0 -> results/real_cell_sweep_*.csv
    python3 tools/real_cell.py --run real1 ai --speed 120  # AI (1)+(2) with a SIMULATED sun clock
    python3 tools/real_cell.py --run real1 check           # 2 min bring-up check of a new cell: PASS/FAIL per item (Wi-Fi/CSE, sensors, steps, direction)
    python3 tools/real_cell.py --run real1 app             # the phone app: POST 127.0.0.1:9600/level {"level": 0..100, "i": cell}
                                                           # and /mode {"mode": "privacy" | "auto"}: privacy = all dark, the cells' watchdog and link-loss fail-safe do not open them

Every mode resends the last angle at least every HEARTBEAT_MIN (wall time) so the cell's 30 min watchdog never opens
it while this runs, and sends OPEN (angle 0) on exit or Ctrl+C. CSE errors are retried with backoff 1, 2, 4 .. 60 s.
Without hardware run tools/fake_cell.py with the same --run first; its readings are marked fake and so is the CSV.
"""
import argparse
import csv
import json
import math
import re
import sys
import threading
import time
from datetime import datetime, timedelta
from http.server import BaseHTTPRequestHandler, ThreadingHTTPServer
from pathlib import Path

import numpy as np
import requests

sys.path.insert(0, str(Path(__file__).resolve().parent.parent))
from polagrid import evaluate, online                              # noqa: E402
from polagrid.closed_loop import HEARTBEAT_MIN, Control                     # noqa: E402
from polagrid.onem2m import Client, _headers, con as cin_con   # noqa: E402
from polagrid.physics import KST, Room, sun_position, window_lux   # noqa: E402
from polagrid.zone import ALL, Controller, grant_discovery, make_acp, remote, roles                        # noqa: E402
from live_learning import LivePreference                           # noqa: E402

RESULTS = Path(__file__).resolve().parent.parent / "results"
MODELS = Path(__file__).resolve().parent.parent / "models"
SWEEP = [0, 10, 20, 30, 40, 50, 60, 70, 80, 90, 0]
CSE_ERRORS = (requests.RequestException, RuntimeError, OSError, ValueError, KeyError, TypeError)   # odd replies too
# One 150 mm cell and one desk sensor in front of it (the demo table). Geometry is a guess, only the AI prior uses it.
ROOM = Room(rows=1, cols=1, cell_w=0.15, cell_h=0.15, desks=[(0.0, 0.6, 0.4, 0.3, 0.75)])


def backoff_s(fails):
    """Wait after n failures in a row: 1, 2, 4 ... 60 s (the firmware's m2m::backoffMs)."""
    return 0 if fails <= 0 else min(60, 2 ** min(fails - 1, 6))


def retry(fn, what, tries=None, sleep=time.sleep):
    """fn() until it stops raising a CSE error. tries=None retries forever; otherwise None after `tries` failures."""
    fails = 0
    while True:
        try:
            return fn()
        except CSE_ERRORS as e:
            fails += 1
            if tries is not None and fails >= tries:
                print(f"[retry] {what} failed {fails}x, giving up: {e}")
                return None
            print(f"[retry] {what}: {str(e)[:120]}; again in {backoff_s(fails)} s")
            sleep(backoff_s(fails))


def malus_fit(angles, lux):
    """Fit lux = a cos^2(angle - offset) + b (offset searched over -15..15 deg). Returns a, b, offset, rms residual."""
    th, y = np.radians(np.asarray(angles, float)), np.asarray(lux, float)
    best = None
    for off in np.arange(-15, 15.05, 0.1):
        x = np.column_stack([np.cos(th - math.radians(off)) ** 2, np.ones_like(th)])
        coef, *_ = np.linalg.lstsq(x, y, rcond=None)
        rms = float(np.sqrt(np.mean((x @ coef - y) ** 2)))
        if best is None or rms < best[3]:
            best = (float(coef[0]), float(coef[1]), round(float(off), 1), rms)
    return best


def sweep_rows(points):
    """[(angle, [lux readings])] -> [(angle, mean lux, ratio to the first point)]. The first point is angle 0."""
    means = [float(np.mean(v)) for _, v in points]
    return [(a, round(m, 1), round(m / means[0], 4) if means[0] else float("nan")) for (a, _), m in zip(points, means)]


def new_readings(get_la, n, timeout_s=120, poll_s=1.0, clock=time.monotonic, sleep=time.sleep):
    """n readings newer than the one there now. get_la() -> (ri, lux, fake) of the newest CIN, or None.
    Returns ([lux], any fake); fewer than n if timeout_s passes."""
    first = get_la()
    seen, out, fake = {first[0]} if first else set(), [], False
    end = clock() + timeout_s
    while len(out) < n and clock() < end:
        sleep(poll_s)
        r = get_la()
        if r and r[0] not in seen:
            seen.add(r[0])
            out.append(r[1])
            fake |= r[2]
    return out, fake


class Cell:
    """The controller side of the one-cell zone, with heartbeat and safe exit."""

    def __init__(self, client, run, port):
        self.c, self.run, self.me = client, run, roles(run)["ctl"]
        self.ctl = Controller(client, run, port)
        self.ctl.seq = int(time.time())   # command ids must differ from an earlier run's: the cell skips a repeated id
        self.angle, self.sent = 0.0, time.monotonic()
        self.lock, self.stop = threading.Lock(), threading.Event()

    def setup(self):
        print(f"[setup] waiting for cell {self.run}p0 on {self.c.host}/{self.c.cse} ...")
        retry(lambda: self.ctl.setup(1, exist_ok=True), "controller setup")
        print("[setup] controller ready (group of 1 cell, desk subscription)")
        threading.Thread(target=self._heartbeat, daemon=True).start()

    def send(self, angle, tries=None):
        """Command one angle; (seconds until the cell's desk reply, desk lux) or None if the cell did not answer."""
        angle = min(90.0, max(0.0, float(angle)))

        def once():
            try:
                t0 = time.perf_counter()
                r = self.ctl.command([angle])
                return time.perf_counter() - t0, float(r["desk_lux"][0])
            except TimeoutError:
                return None                           # the CIN is posted; the cell did not report back in 30 s
        with self.lock:
            got = retry(once, f"command {angle}", tries)
            self.angle, self.sent = angle, time.monotonic()
        return got

    def _heartbeat(self):
        while not self.stop.wait(10):
            if time.monotonic() - self.sent >= HEARTBEAT_MIN * 60:
                print(f"[heartbeat] resend {self.angle:.0f} deg")
                self.send(self.angle)

    def la(self, path):
        """(ri, con) of the newest CIN or the resource at path, as the controller."""
        r = self.c._session().get(f"{self.c.host}/{self.c.cse}/{path}", headers=_headers(self.me), timeout=30)
        if r.status_code != 200:
            raise RuntimeError(f"GET {path}: {r.status_code} {r.text[:120]}")
        return r.json()

    def state(self):
        return self.la(f"{self.run}p0/state")["cod:opeLl"]["opeLl"]

    def lux(self, sensor):
        """Newest reading (ri, lux, fake) of the cell sensor ({run}p0/lux) or the desk sensor ({run}env/desks)."""
        path = f"{self.run}p0/lux/la" if sensor == "cell" else f"{self.run}env/desks/la"
        cin = self.la(path)["m2m:cin"]
        con = cin_con(cin)
        return cin["ri"], float(con["lux"] if sensor == "cell" else con["lux"][0]), bool(con.get("fake"))

    def close(self):
        """OPEN on exit. Bounded retries; if they all fail the cell's own watchdog opens it within 30 min."""
        self.stop.set()
        print("[exit] sending OPEN (0 deg)")
        got = self.send(0, tries=5)
        print("[exit] cell open" if got else "[exit] no reply from the cell; its watchdog opens it within 30 min")


def show(cell, angle, got):
    if got is None:
        print(f"  {angle:.0f} deg: no desk reply within 30 s (cell offline, or the disc did not arrive)")
        return
    want = round(100 * math.cos(math.radians(angle)) ** 2)
    level = None
    for _ in range(5):                             # the cell PUTs state at most once a second, it can lag the reply
        level = retry(cell.state, "read state", 3)
        if level == want:
            break
        time.sleep(1)
    cl = retry(lambda: cell.lux("cell"), "read cell lux", 3)
    print(f"  {angle:.0f} deg: applied in {got[0]:.1f} s, state opeLl={level} (expect {want}), "
          f"desk {got[1]:.1f} lux, cell sensor (newest, up to 10 s old) {cl[1] if cl else '?'} lux{'  [FAKE CELL]' if cl and cl[2] else ''}")


def manual(cell, a):
    for v in a.angles:
        show(cell, v, cell.send(v))
    if a.angles:
        return
    print("angle 0..90 (0 = open), empty line or q to quit")
    while (line := input("> ").strip()) not in ("", "q"):
        try:
            v = float(line)
        except ValueError:
            print("  not a number")
            continue
        if not 0 <= v <= 90:
            print("  0..90 only")
            continue
        show(cell, v, cell.send(v))


def app_mode(client, run, a):
    """The phone app's cell control (via demo/server.py), 127.0.0.1 only: POST /level {"level": 0..100, "i": cell index | "cells": [indexes]; none = every cell}.
    Each cell gets its own command CIN in {run}p<i>/command (angle list long enough for its CELL_INDEX), so a cell added later
    works at once; no command group. Cells are found by the state label. The newest command wins, a heartbeat keeps each
    cell's last angle fresh, and exit opens every cell."""
    me, lock, sent, seq = roles(run)["ctl"], threading.Lock(), {}, [int(time.time())]
    privacy, before = [False], {}   # privacy mode: every cell dark, kept dark by the cells themselves; before = angles to return to

    def cells():
        uris = retry(lambda: client.discover(me, lbl=f"polagrid/{run}/state", ty=28), "discover cells", 3) or []
        return sorted({int(m[1]) for u in uris if (m := re.search(rf"(?:^|/){run}p(\d+)/state$", u))})

    def command(idx, angle, tries=3, mode=None):
        with lock:
            seq[0] += 1
            body = {"cmd": f"{run}a{seq[0]}", "angles": [round(angle, 1)] * (idx + 1)}   # the cell reads entry CELL_INDEX
            if mode:
                body["mode"] = mode
            if retry(lambda: client.create(f"{run}p{idx}/command", me, body), f"command p{idx}", tries) is not None:
                sent[idx] = (angle, time.monotonic(), mode)

    def set_privacy(on):
        """POST /mode {"mode": "privacy" | "auto"}. Privacy closes every cell and the cells then ignore their watchdog; auto
        puts each cell back at its angle from before (open if there was none)."""
        targets = cells()
        if on and not privacy[0]:
            before.update({k: sent[k][0] for k in targets if k in sent and sent[k][2] != "privacy"})
        privacy[0] = on
        for k in targets:
            if on:
                command(k, 90.0, mode="privacy")
            else:
                command(k, before.pop(k, 0.0))
        print(f"[app] privacy {'on' if on else 'off'} -> cells {targets}")
        return targets

    class H(BaseHTTPRequestHandler):
        def do_POST(self):
            if self.path == "/mode":
                try:
                    mode = json.loads(self.rfile.read(int(self.headers.get("Content-Length", 0))))["mode"]
                    if mode not in ("privacy", "auto"):
                        raise ValueError
                except (ValueError, KeyError, TypeError):
                    return self.send_error(400, 'need JSON {mode: "privacy" | "auto"}')
                body = json.dumps({"mode": mode, "cells": set_privacy(mode == "privacy")}).encode()
                self.send_response(202)
                self.send_header("Content-Length", str(len(body)))
                self.end_headers()
                return self.wfile.write(body)
            if privacy[0]:
                return self.send_error(409, 'privacy mode is on: POST /mode {"mode": "auto"} first')
            try:
                req = json.loads(self.rfile.read(int(self.headers.get("Content-Length", 0))))
                level = float(req["level"])
                idx = None if req.get("i") is None else int(req["i"])
                picked = None if req.get("cells") is None else [int(k) for k in req["cells"]]
                if not 0 <= level <= 100 or (idx is not None and idx < 0) or (picked is not None and min(picked, default=0) < 0):
                    raise ValueError
            except (ValueError, KeyError, TypeError, AttributeError):
                return self.send_error(400, "need JSON {level: 0..100, i: cell index or cells: [indexes], optional}")
            angle = math.degrees(math.acos(math.sqrt(level / 100)))   # opeLl = 100 cos^2(angle)
            targets = [idx] if idx is not None else sorted(set(picked)) if picked is not None else cells()
            for k in targets:
                command(k, angle)
            print(f"[app] level {level:.0f} (angle {angle:.1f}) -> cells {targets}")
            body = json.dumps({"level": level, "angle": round(angle, 1), "cells": targets}).encode()
            self.send_response(202)
            self.send_header("Content-Length", str(len(body)))
            self.end_headers()
            self.wfile.write(body)

        def log_message(self, *args):
            pass

    def heartbeat():
        while True:
            time.sleep(10)
            for idx, (angle, t, mode) in list(sent.items()):
                if time.monotonic() - t >= HEARTBEAT_MIN * 60:
                    command(idx, angle, mode=mode)

    def setup():
        """The controller's own ACP and AE, and discovery under the CSE base: a fresh database has none of them (zone.py's
        Controller.setup does the same). Safe to repeat."""
        grant_discovery(client)
        make_acp(client, f"{run}ctlacp", [(remote(me), ALL)], exist_ok=True)
        client.post("", me, {"m2m:ae": {"rn": f"{run}ctl", "api": "Npolagrid", "rr": False, "srv": ["3"]}}, 2, exist_ok=True)

    print(f"[app] waiting for the CSE on {client.host}/{client.cse} ...")
    retry(setup, "controller setup")
    threading.Thread(target=heartbeat, daemon=True).start()
    server = ThreadingHTTPServer(("127.0.0.1", a.app_port), H)
    print(f"[app] cell control at http://127.0.0.1:{a.app_port}/level, Ctrl+C to stop (every cell opens on exit)")
    try:
        server.serve_forever()
    except KeyboardInterrupt:
        print()
    finally:
        if privacy[0]:
            print("[exit] privacy mode is on: the cells stay dark until the app sends /mode auto or the button is pressed")
        else:
            print("[exit] opening every cell")
            for idx in list(sent):
                command(idx, 0, tries=5)


def check(cell, a):
    """Bring-up check of the real cell from the PC side, before the 10/24 sweep: it moves the disc 0, 45, 90, 0 deg.
    Prints PASS/FAIL per item; the exit code is 1 if anything failed. Needs a cell that has booted and reached the CSE."""
    rows, fake = [], False

    def rec(name, ok, detail):
        rows.append(ok)
        print(f"  {'PASS' if ok else 'FAIL'}  {name}: {detail}")

    level = retry(cell.state, "read state", 3)
    rec("cell on the CSE (Wi-Fi, provisioning)", level is not None, f"state opeLl={level}" if level is not None else
        "no state: is the ESP32 on, on the same Wi-Fi as the MN, and RUN_ID/CSE_HOST right? (serial shows 'CSE ready')")
    if level is None:
        return rows
    for sensor, what in (("cell", "cell sensor BH1750 0x23"), ("desk", "desk sensor BH1750 0x5C")):
        vals, f = new_readings(lambda: retry(lambda: cell.lux(sensor), "read lux", 3), 1, timeout_s=30)
        fake |= f
        rec(what, bool(vals), f"{vals[0]:.1f} lux" if vals else "no new reading in 30 s (sensor wiring, I2C address, or the cell is not posting)")
    got, lux0 = {}, {}
    for ang in (0, 45, 90, 0):
        r = cell.send(ang)
        if r is None:
            rec(f"{ang} deg applied", False, "no desk reply within 30 s (motor stuck, homing not done, or command not received)")
            return rows
        vals, f = new_readings(lambda: retry(lambda: cell.lux("cell"), "read lux", 3), 2, timeout_s=45)
        fake |= f
        lv = retry(cell.state, "read state", 3)
        want = round(100 * math.cos(math.radians(ang)) ** 2)
        got[ang] = (r[0], lv, float(np.mean(vals[-1:])) if vals else None)
        rec(f"{ang} deg applied", r[0] <= 20 and lv is not None and abs(lv - want) <= 2,
            f"in {r[0]:.1f} s (expect 15 s or less), state opeLl={lv} (expect {want})")
    lo, hi = got[90][2], got[0][2]
    if lo is None or hi is None or hi <= 0:
        rec("direction and steps", False, "no cell-sensor readings to compare")
    else:
        mid = got[45][2] / hi if got[45][2] is not None else float("nan")
        rec("direction (lux falls toward 90 deg)", lo < 0.5 * hi, f"90 deg {lo:.0f} lux vs 0 deg {hi:.0f} lux (ratio {lo / hi:.2f}; "
            "if it does not fall the disc turns the wrong way, the film axes are parallel, or the disc did not move)")
        rec("steps (45 deg is about half of 0 deg)", 0.3 <= mid <= 0.7, f"ratio {mid:.2f} (cos^2 model 0.50; the leak and the film make it differ, "
            "far off means the half steps per degree need calibrating)")
    back = got[0][2]
    if back is not None and hi and hi > 0:
        rec("returns to 0 deg", abs(back - hi) <= 0.15 * hi, f"{back:.0f} lux vs {hi:.0f} lux at the start")
    print(f"[check] {sum(rows)}/{len(rows)} passed" + ("  (FAKE cell, not hardware)" if fake else ""))
    return rows


def sweep(cell, a):
    points, fake = [], False
    for ang in SWEEP:
        got = cell.send(ang)
        if got is None:
            print(f"  {ang} deg: cell did not settle (no desk reply), stopping the sweep")
            break
        vals, f = new_readings(lambda: retry(lambda: cell.lux(a.sensor), "read lux", 3), a.n,
                               timeout_s=a.n * 15 + 30)
        fake |= f
        if not vals:
            print(f"  {ang} deg: no new {a.sensor} readings, stopping the sweep")
            break
        points.append((ang, vals))
        print(f"  {ang:>2} deg: settled in {got[0]:.1f} s, {len(vals)} readings, mean {np.mean(vals):.1f} lux")
    if len(points) < 3:
        print("[sweep] too few points, no CSV")
        return
    rows = sweep_rows(points)
    tag = "_FAKE" if fake else ""
    out = RESULTS / f"real_cell_sweep{tag}_{datetime.now():%m%d_%H%M}.csv"
    with open(out, "w", newline="") as f:
        if fake:
            f.write("# FAKE DATA from tools/fake_cell.py (simulated cos^2 model), not a measurement\n")
        f.write(f"# run {cell.run}, sensor {a.sensor}, {a.n} readings per angle, {datetime.now(KST).isoformat()}\n")
        w = csv.writer(f)
        w.writerow(["angle", "lux", "ratio"])
        w.writerows(rows)
    amp, base, off, rms = malus_fit([r[0] for r in rows], [r[1] for r in rows])
    print(f"[sweep] wrote {out}{'  (FAKE data)' if fake else ''}")
    print(f"[malus] lux = {amp:.1f} cos^2(angle {-off:+.1f}) + {base:.1f}, rms residual {rms:.1f} lux "
          f"({100 * rms / max(abs(amp), 1e-9):.1f}% of the swing); repeat 0 deg ratio {rows[-1][2]}")


def level_to_angle(level):
    """The app's open level 0..100 to a disc angle: opeLl = 100 cos^2(angle)."""
    return math.degrees(math.acos(math.sqrt(level / 100)))


def serve_manual(port, manual, hold_s):
    """The phone page's slider (POST /level {"level": 0..100}) and privacy (POST /mode {"mode": "privacy" | "auto"}) while the AI
    loop runs. A slider move holds that angle for hold_s seconds, then the AI takes over; privacy holds 90 deg until "auto"."""
    class H(BaseHTTPRequestHandler):
        def do_POST(self):
            try:
                req = json.loads(self.rfile.read(int(self.headers.get("Content-Length", 0))))
                if self.path == "/mode":
                    if req["mode"] not in ("privacy", "auto"):
                        raise ValueError
                    manual.update(angle=90.0 if req["mode"] == "privacy" else None, until=math.inf)
                else:
                    level = float(req["level"])
                    if not 0 <= level <= 100:
                        raise ValueError
                    manual.update(angle=level_to_angle(level), until=time.monotonic() + hold_s)
            except (ValueError, KeyError, TypeError, AttributeError):
                return self.send_error(400, 'need JSON {level: 0..100} on /level or {mode: "privacy" | "auto"} on /mode')
            body = json.dumps({"angle": manual["angle"]}).encode()
            self.send_response(202)
            self.send_header("Content-Length", str(len(body)))
            self.end_headers()
            self.wfile.write(body)

        def log_message(self, *args):
            pass

    threading.Thread(target=ThreadingHTTPServer(("127.0.0.1", port), H).serve_forever, daemon=True).start()


def hold_closed(desk_lux, closed, close_lux):
    """Hysteresis of the real cell's full close: shut above close_lux, reopen only below half of it (0 = off)."""
    if not close_lux:
        return False
    if desk_lux > close_lux:
        return True
    return closed and desk_lux >= close_lux / 2


def ai_loop(cell, a):
    """AI (1) online + AI (2) for one cell. Desk lux is the real sensor; the sun is a SIMULATED accelerated clock."""
    t0 = datetime.fromisoformat(a.start).replace(tzinfo=KST)
    sim_t, last = t0, time.monotonic()
    page = Control(a.cloud, ROOM.window_azimuth) if a.control_port else None   # the demo page's Start / speed / Cloud / Reset
    if page:
        page.serve(a.control_port)
    kw = {}
    if a.learn:   # AI (1) state and AI (3) preference survive a restart; a faulty judgement still opens the cell
        pref = LivePreference(include_fake=a.learn_fake, source=a.pref)
        kw = {"state_path": MODELS / ("filter_FAKE.npz" if a.learn_fake else "filter_real.npz"), "save_every": 1,
              "glare_offset": lambda ctx: pref.offset(datetime.now(KST))}   # wall clock: that is when the app stamps corrections
    MODELS.mkdir(exist_ok=True)
    ctrl = evaluate.fail_open(online.polagrid_online(ROOM, **kw))
    env = roles(cell.run)["env"]
    closed, manual = False, {"angle": None, "until": 0.0}
    if a.app_port:
        serve_manual(a.app_port, manual, a.manual_hold_s)
    print(f"[ai] SIMULATED SUN: clock starts {t0:%m-%d %H:%M}, {a.speed:g}x; desk lux from the real sensor"
          + ("; learning ON (filter + preference saved in models/)" if a.learn else "; learning off"))
    while True:
        tick = time.monotonic()
        if page and page.reset:
            sim_t, page.reset, page.running = t0, False, False
        if not page or page.running:   # with the page's controls the clock waits for Start; the loop still follows the desk sensor
            sim_t += timedelta(seconds=(tick - last) * a.speed * (page.speed if page else 1.0))
        last, t, cloud = tick, sim_t, (page.cloud if page else a.cloud)
        alt, az = sun_position(t, ROOM.lat, ROOM.lon)
        sun = {"t": t.isoformat(), "alt": round(alt, 2), "az": round(az, 2), "outdoor": round(window_lux(ROOM, t, cloud))}
        retry(lambda: cell.c.create(f"{cell.run}env/sun", env, sun), "publish sun")
        sun = retry(cell.ctl.sun, "read sun")
        desk = retry(cell.ctl.desks, "read desks")
        new = ctrl({"t": t, "outdoor": sun["outdoor"], "angles": np.array([cell.angle]), "desk_lux": desk})
        # 10-31: the cell's optics reach far less than the model's cos^2 (about 40 deg of motor range), so a desk this bright shuts fully
        closed = hold_closed(desk[0], closed, a.close_lux)
        if closed:
            new = np.array([90.0])
        if manual["angle"] is not None and time.monotonic() < manual["until"]:   # the person's slider beats the AI for a while
            new = np.array([manual["angle"]])
        line = f"[ai] sim {t:%H:%M} sun alt {alt:5.1f} outdoor {sun['outdoor']:>6} lux | desk {desk[0]:7.1f} lux"
        if a.learn and pref.model is not None:
            line += f" | pref {pref.offset(datetime.now(KST)):+5.0f} lux ({max(0, pref.rows)} corr.)"
        if abs(new[0] - cell.angle) > 0.05:
            got = cell.send(new[0])
            line += f" -> {new[0]:.0f} deg" + (f" in {got[0]:.1f} s" if got else " (no reply)")
        print(line + f" | cell at {cell.angle:.0f} deg")
        time.sleep(max(0.0, a.step - (time.monotonic() - tick)))


def main():
    ap = argparse.ArgumentParser(description=__doc__.split("\n")[0])
    ap.add_argument("--host", default="http://127.0.0.1:3001", help="MN as this PC sees it (CSE_HOST)")
    ap.add_argument("--cse", default="TinyIoT-mn001", help="CSE_NAME")
    ap.add_argument("--run", default="real1", help="RUN_ID")
    ap.add_argument("--port", type=int, default=9791, help="notification port of this process")
    sub = ap.add_subparsers(dest="mode", required=True)
    m = sub.add_parser("manual")
    m.add_argument("angles", nargs="*", type=float, help="angles to apply in order; none = prompt")
    sub.add_parser("check")
    p = sub.add_parser("app")
    p.add_argument("--app-port", type=int, default=9600)
    s = sub.add_parser("sweep")
    s.add_argument("--n", type=int, default=5, help="lux readings averaged per angle (one every 10 s)")
    s.add_argument("--sensor", choices=["cell", "desk"], default="cell")
    i = sub.add_parser("ai")
    i.add_argument("--start", default="2026-11-04T09:00", help="simulated clock start (KST)")
    i.add_argument("--speed", type=float, default=60, help="simulated seconds per wall second")
    i.add_argument("--step", type=float, default=20, help="wall seconds per control step (a 90 deg turn takes ~13 s)")
    i.add_argument("--cloud", type=float, default=0.0, help="simulated cloud 0..1")
    i.add_argument("--close-lux", type=float, default=2000.0,
                   help="desk lux above which the cell shuts fully (90 deg) whatever the model says; it reopens below half of it; 0 = off")
    i.add_argument("--app-port", type=int, default=0,
                   help="also take the phone page's slider and privacy here (the demo server posts to 9600): a slider move holds that angle for --manual-hold-s")
    i.add_argument("--manual-hold-s", type=float, default=120.0, help="seconds a slider move beats the AI")
    i.add_argument("--control-port", type=int, default=0,
                   help="listen here for the demo page's controls (running, speed, cloud, reset; same as the virtual zones); the clock then waits for Start")
    i.add_argument("--no-learn", dest="learn", action="store_false", help="do not keep the filter or refit from the app's corrections")
    i.add_argument("--pref", choices=["server", "web"], default="server",
                   help="AI (3) preference: server = fitted here from corrections.db; web = the model the phone page learned in its browser")
    i.add_argument("--learn-fake", action="store_true", help="also learn from fake-cell correction rows (own FAKE files, to try the chain)")
    a = ap.parse_args()
    if a.mode == "manual" and any(not 0 <= v <= 90 for v in a.angles):
        ap.error("angles must be 0..90")

    if a.mode == "app":
        return app_mode(Client(a.host, a.cse), a.run, a)
    cell = Cell(Client(a.host, a.cse), a.run, a.port)
    try:
        cell.setup()
        res = {"manual": manual, "sweep": sweep, "ai": ai_loop, "check": check}[a.mode](cell, a)
        if a.mode == "check" and not all(res):
            sys.exit(1)
    except (KeyboardInterrupt, EOFError):
        print()
    finally:
        cell.close()


if __name__ == "__main__":
    main()
