gustjr3332/Polargrid/sw/actuator/tests_host/test_logic.cpp

// g++ -std=c++17 -I src tests_host/test_logic.cpp -o test_logic && ./test_logic
#include <cassert>
#include <cstdio>
#include "cell_logic.h"

int main() {
  const long full = (long)(MOTOR_CLOSED_DEG * STEPS_PER_DISC_DEG + 0.5f);   // command 90 = the measured dark motor angle
  assert(stepsFromDisc(0) == (long)(MOTOR_OPEN_DEG * STEPS_PER_DISC_DEG + 0.5f) && stepsFromDisc(90) == full);
  assert(stepsFromDisc(45) == (long)(MOTOR_OPEN_DEG * STEPS_PER_DISC_DEG + (full - MOTOR_OPEN_DEG * STEPS_PER_DISC_DEG) / 2 + 0.5f));
  assert(discFromMotor(MOTOR_OPEN_DEG) == 0 && discFromMotor(MOTOR_CLOSED_DEG) == DISC_MAX_DEG);
  assert(stepsFromDisc(-10) == 0 && stepsFromDisc(120) == full);         // clamped to the 0..90 range

  Cells c;
  assert(parseCommand("A 0 45", c, 100) == Result::Ok && c.disc[0] == 45 && c.lastCmdMs == 100);
  assert(parseCommand("A 1 10", c, 200) == Result::BadCell && c.lastCmdMs == 100);
  assert(parseCommand("hello", c, 200) == Result::BadCommand && c.lastCmdMs == 100);
  assert(parseCommand("ALL 200", c, 300) == Result::Ok && c.disc[0] == 90);

  assert(!watchdog(c, 300 + WATCHDOG_MS));                                // exactly at the limit: still closed
  assert(watchdog(c, 301 + WATCHDOG_MS) && c.disc[0] == 0);
  assert(!watchdog(c, 302 + WATCHDOG_MS));                                // already open: no repeat
  parseCommand("OPEN", c, 400);
  assert(c.disc[0] == 0);

  // privacy mode: closed, and neither the watchdog nor a FAILSAFE opens it; only the user's OPEN (button, serial) does
  Cells p;
  parseCommand("A 0 90", p, 1000);
  assert(parseCommand("PRIV 1", p, 1000) == Result::Ok && p.privacy && p.disc[0] == 90);
  assert(!watchdog(p, 1000 + 10 * WATCHDOG_MS) && p.disc[0] == 90);       // no controller for hours: stays dark
  assert(parseCommand("FAILSAFE", p, 2000) == Result::Ok && p.disc[0] == 90);
  assert(parseCommand("OPEN", p, 3000) == Result::Ok && !p.privacy && p.disc[0] == 0);
  // outside privacy FAILSAFE opens at once, and PRIV 0 only clears the flag
  Cells f;
  parseCommand("A 0 60", f, 1000);
  assert(parseCommand("FAILSAFE", f, 1100) == Result::Ok && f.disc[0] == 0);
  parseCommand("PRIV 1", f, 1200);
  assert(parseCommand("PRIV 0", f, 1300) == Result::Ok && !f.privacy);
  assert(parseCommand("PRIV", f, 1400) == Result::BadCommand);

  // stepper: homes first (pos = 0 at the stop), then reaches the target one half step at a time
  Stepper m;
  m.target = 100;
  long homing = 0;
  while (!m.homed) { assert(m.step() >= 0 || m.homed); homing++; }
  assert(homing == (long)(HOME_OVERDRIVE_DEG * STEPS_PER_DISC_DEG + 0.5f) + 1 && m.pos == 0);
  int mask = 0; long n = 0;
  while ((mask = m.step()) >= 0) { assert(mask == HALF_STEP[m.phase]); n++; }
  assert(n == 100 && m.pos == 100 && m.step() == -1);                    // idle again: coils off
  m.target = 40;
  n = 0; while (m.step() >= 0) n++;
  assert(n == 60 && m.pos == 40);                                         // reverses
  // up and back down returns to the same coil phase pattern (no drift in the table)
  Stepper z; z.homed = true; z.target = 8; while (z.step() >= 0) {}
  assert(z.phase == 0); z.target = 0; while (z.step() >= 0) {}
  assert(z.phase == 0 && z.pos == 0);
  // Bluetooth line protocol: PING is not a command, A/FAILSAFE ask a desk reply, output lines as bt_bridge.py parses them
  Cells b;
  assert(isPing("PING") && !isPing("PING 1") && parseCommand("PING", b, 5) == Result::BadCommand && b.lastCmdMs == 0);
  assert(replySteps("A 0 45") == stepsFromDisc(45) && replySteps("A 0 120") == full && replySteps("FAILSAFE") == 0);
  assert(replySteps("PRIV 1") == -1 && replySteps("OPEN") == -1 && replySteps("PING") == -1);
  char line[48];
  posLine(line, sizeof line, 45.04f);         assert(!strcmp(line, "POS 45.0\n"));
  deskLine(line, sizeof line, 120.46f);       assert(!strcmp(line, "DESK 120.5\n"));
  luxLine(line, sizeof line, 300.0f, -1.0f);  assert(!strcmp(line, "LUX 300.0 -1.0\n"));
  puts("all tests passed");
}
