gustjr3332/Polargrid/(commit log)

2026-10-08 Initial PolaGrid repo: hw / sw(edge_ai, actuator, app_ui) layout
    Edge AI code, tinyIoT sim setup, tools and measurement results moved from
    onem2m_ton. Working documents stay local (gitignored).
2026-10-12 Pre-train AI (3) on virtual days, online AI (1) contribution filter, virtual-user preference test
    - virtual.py: train/save/load predictor, domain randomization (off by default, no gain), robustness check
    - online.py: Kalman-filter contribution estimate from operating data instead of probing
    - prefs.py: virtual users for the too-bright correction; fit_preference scales its inputs
    - closed_loop --model loads a saved predictor; evaluate passes desk_lux to controllers
    Claude-Session: https://claude.ai/code/session_01N2my3JvJhkU9rDFS7rqhoH
2026-10-12 Add Android app draft (screens, oneM2M data flow, stack)
    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
2026-10-15 Add demo page P0 (fake-data 1,000-cell view) and 1,000-cell closed-loop results
    demo/static/index.html draws a 25x40 canvas grid from generated frames behind
    one onFrame() entry. Results cover 100/300/1,000 cells, CPU contention, and
    repeat runs with both controllers.
    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
2026-10-16 Add ESP32 firmware skeleton with Wokwi simulation and hardware notes
2026-10-16 Add demo server with flow viewer, 1,000-cell read timing, and app screen mockup
    Reading 1,000 cell states from the CSE: p50 1.30 s, p95 1.65 s when run alone.
2026-10-17 Connect demo page to live/replay frames over SSE
    The page now reads /api/events when served by demo/server.py and falls back
    to the fake generator (or ?fake). Null glare_h and lat_ms show as "-".
2026-10-17 Add 4-cell hardware initial model: wiring and concept diagrams, part photos, servo pin change
    Servo pins 13/26/14/27 (GPIO12 strapping pin avoided), diagonal-corner pinion layout.
    Host test passed; pio build not rerun after the pin change.
2026-10-17 Wire demo page controls to live zones (P2)
    closed_loop --serve takes start/stop, speed, cloud, window turn and reset on a control port;
    server /api/ctl forwards them to every zone; the page shows the panel only in live mode.
2026-10-18 Change hardware scope to one control module: 1 cell, central module concept
    Firmware N_CELLS=1 (host test passes, pio/Wokwi not rerun), no I2C mux,
    wiring and concept diagrams redrawn, hw README updated.
2026-10-18 Redesign hardware as a 150 mm cell with rim-toothed disc and stepper drive
    Corner-space calculation, scaled front view and section drawing, wiring for a
    28BYJ-48 + ULN2003 on USB power. Firmware still drives a servo (noted in the README).
2026-10-18 Rewrite firmware for the 28BYJ-48 stepper and add laser-cut DXF drawings
    Half-step drive with homing against a stop pin, host test and pio build pass.
    hw/cutting generates DXF for the groove plate, rim-toothed disc, back ring plate,
    pinion, stop pins and film outlines. Wokwi servo simulation removed.
2026-10-18 Remove the old 30 mm concept drawing, sync docs with the 150 mm cell
2026-10-18 Add Wi-Fi and oneM2M HTTP polling to the ESP32 firmware
    Same resource tree as the simulated cell in zone.py; HTTP runs in a separate task so the
    stepper timing is not blocked. Host tests and pio build pass; nothing run on hardware or a real MN yet.
2026-10-20 Add fail-open on link loss or nonsense angle, privacy mode, and I2C scanner
    Cell opens after 60 s without a CSE reply or on an angle outside 0..90; privacy mode keeps every cell dark against the watchdog; PC side fail_open wrapper and /mode endpoint; BH1750 I2C scanner project.
2026-10-25 Add Bluetooth bridge for the real cell, wireless-upload env, and I2C check sketch
    - firmware: env:bt (classic Bluetooth SPP, no Wi-Fi) with PING-based fail-open; env:ota for Wi-Fi upload
    - sw/edge_ai/tools/bt_bridge.py relays the cell's serial lines to the MN-CSE; tests added
    - hw/cutting: 3 mm disc dxf replaces the 2 mm files
2026-10-30 Live preference learning: browser Ridge, controller connection, filter persistence; IN-outage test tools
2026-11-01 Real cell: closed angle 33 deg from 11-01 sweeps, AI pre-trained preference, demo and tools updates
    - cell_logic.h: MOTOR_CLOSED_DEG 40 -> 33 (two sweeps put the darkest reading at command 70..75 deg); cell sensor reads 0.0 lux closed
    - results: real_cell_sweep_1101_1505.csv (n=3), real_cell_sweep_1101_1516.csv (n=5)
    - tools/pretrain_preference.py, real_cell.py, live_learning.py and the demo server/page/scripts from the 10-31 work
2026-11-04 Add 12-cell virtual room view, sensor dataflow diagrams, and sim README
    - app mockup: ?room=12 shows one real cell plus 11 virtual cells; right 6 cells close at/above an editable lux limit (default 2000, ?thr=), left 6 stay open. Virtual lux values are assumptions.
    - hw/diagrams: sensor dataflow diagrams A and B
    - sw/edge_ai/sim: README for the tinyIoT test environment
